funvill/tokyo-metro-pcb/input/reference/Tokyo_subway_map_(metro).png

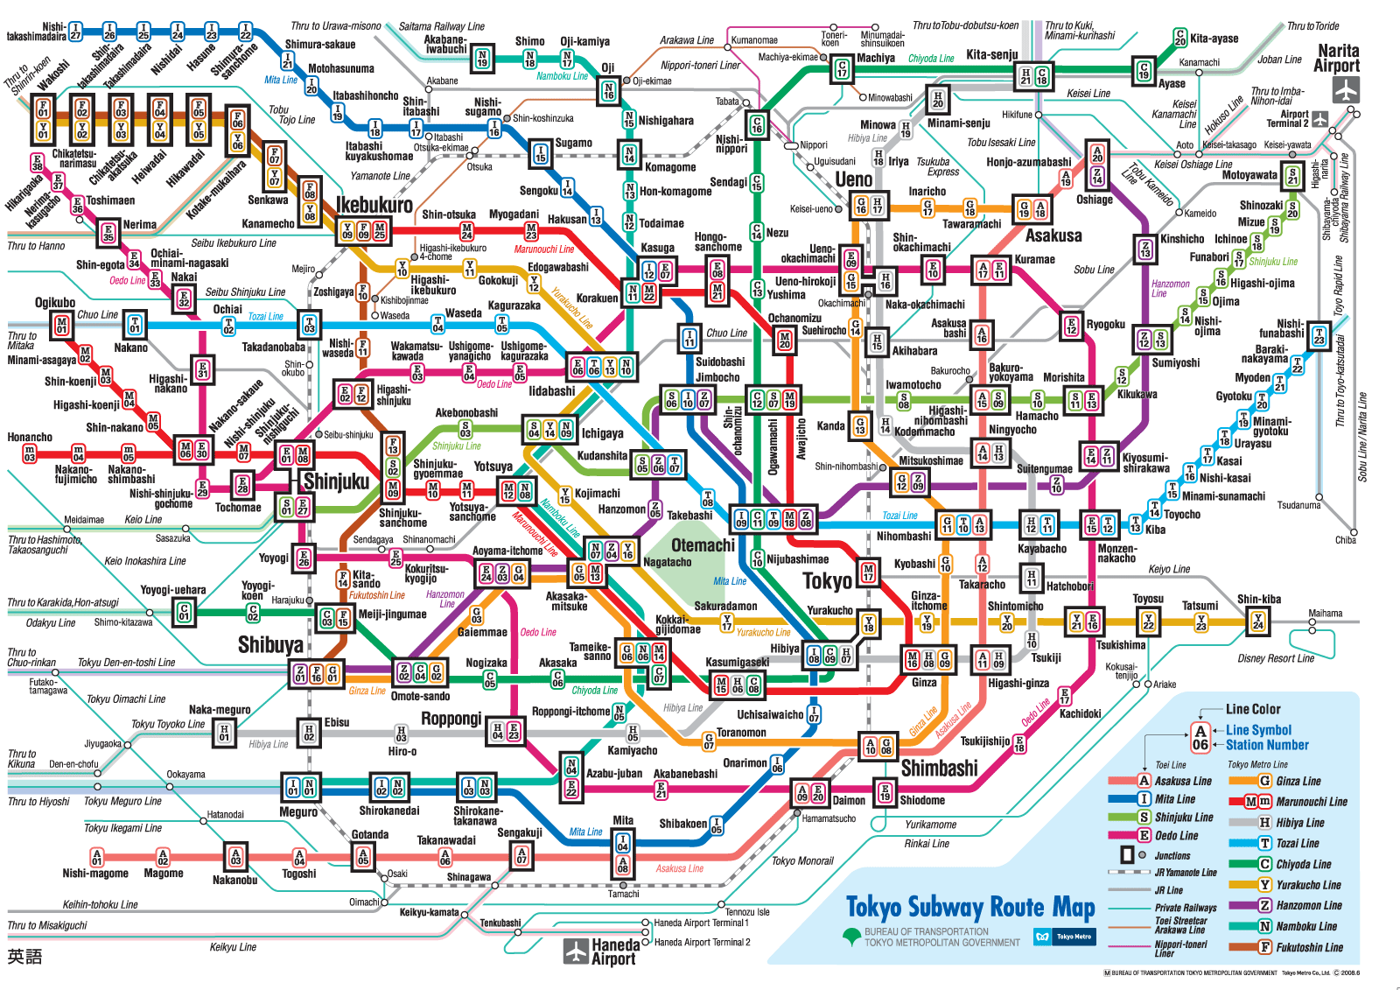
input/reference/Tokyo_subway_map_(metro).png
