funvill/tokyo-metro-pcb/hardware/leds.csv

index | ref | station | name | x_mm | y_mm | rotation
0 | LED1 | shin-kiba | Shin-kiba | 250.084 | 201.26 | 180
1 | LED2 | tatsumi | Tatsumi | 229.098 | 201.948 | 225
2 | LED3 | shinonome | Shinonome | 219.714 | 209.59 | 225
3 | LED4 | ariake | Ariake | 206.75 | 219.444 | 225
4 | LED5 | tokyo-big-sight | Tokyo Big Sight | 203.17 | 225.84 | 90
5 | LED6 | kokusai-tenjijo | Kokusai-tenjijo | 203.428 | 219.794 | 90
6 | LED7 | ariake-tennis-no-mori | Ariake-Tennis-no-mori | 200.162 | 210.596 | 135
7 | LED8 | shijo-mae | Shijo-mae | 196.196 | 201.488 | 45
8 | LED9 | shin-toyosu | Shin-Toyosu | 202.01 | 196.676 | 45
9 | LED10 | toyosu | Toyosu | 209.9 | 186.718 | 45
10 | LED11 | edagawa | Edagawa | 224.042 | 180.784 | 90
11 | LED12 | kiba | Kiba | 223.524 | 161.378 | 0
12 | LED13 | toyocho | Toyocho | 237.978 | 163.088 | 90
13 | LED14 | sengoku-koto | Sengoku | 236.004 | 147.798 | 90
14 | LED15 | sumiyoshi | Sumiyoshi | 235.618 | 131.83 | 90
15 | LED16 | kinshicho | Kinshicho | 234.772 | 120.044 | 225
16 | LED17 | kikukawa | Kikukawa | 223.014 | 132.766 | 225
17 | LED18 | kiyosumi-shirakawa | Kiyosumi-shirakawa | 213.274 | 142.624 | 270
18 | LED19 | monzen-nakacho | Monzen-nakacho | 208.708 | 157.748 | 225
19 | LED20 | tsukishima | Tsukishima | 194.542 | 171.448 | 225
20 | LED21 | kachidoki | Kachidoki | 184.856 | 180.222 | 90
21 | LED22 | tsukiji | Tsukiji | 178.816 | 165.522 | 90
22 | LED23 | shintomicho | Shintomicho | 179.908 | 161.416 | 90
23 | LED24 | takaracho | Takaracho | 177.95 | 153.736 | 135
24 | LED25 | kyobashi | Kyobashi | 175.388 | 151.594 | 225
25 | LED26 | ginza-itchome | Ginza-itchome | 171.488 | 155.434 | 225
26 | LED27 | ginza | Ginza | 167.62 | 159.014 | 135
27 | LED28 | hibiya | Hibiya | 163.31 | 155.658 | 45
28 | LED29 | yurakucho | Yurakucho | 165.034 | 152.82 | 90
29 | LED30 | nijubashimae | Nijubashimae | 166.276 | 146.342 | 45
30 | LED31 | tokyo | Tokyo | 168.754 | 143.076 | 90
31 | LED32 | otemachi | Otemachi | 168.546 | 137.026 | 135
32 | LED33 | takebashi | Takebashi | 160.568 | 130.054 | 90
33 | LED34 | jimbocho | Jimbocho | 159.524 | 121.132 | 180
34 | LED35 | kudanshita | Kudanshita | 149.988 | 121.348 | 135
35 | LED36 | iidabashi | Iidabashi | 144.538 | 112.686 | 0
36 | LED37 | suidobashi | Suidobashi | 155.906 | 108.046 | 135
37 | LED38 | korakuen | Korakuen | 150.894 | 101.682 | 45
38 | LED39 | kasuga | Kasuga | 153.072 | 99.152 | 0
39 | LED40 | hongo-sanchome | Hongo-sanchome | 162.556 | 102.698 | 315
40 | LED41 | ochanomizu | Ochanomizu | 168.212 | 111.272 | 270
41 | LED42 | shin-ochanomizu | Shin-ochanomizu | 169.634 | 118.584 | 270
42 | LED43 | ogawamachi | Ogawamachi | 169.636 | 122.348 | 0
43 | LED44 | awajicho | Awajicho | 172.952 | 121.954 | 315
44 | LED45 | kanda | Kanda | 176.572 | 124.228 | 0
45 | LED46 | iwamotocho | Iwamotocho | 182.372 | 121.966 | 90
46 | LED47 | akihabara | Akihabara | 182.672 | 116.18 | 135
47 | LED48 | suehirocho | Suehirocho | 177.612 | 109.37 | 45
48 | LED49 | okachimachi | Okachimachi | 181.344 | 103.256 | 180
49 | LED50 | ueno-hirokoji | Ueno-hirokoji | 178.18 | 102.184 | 180
50 | LED51 | yushima | Yushima | 174.872 | 102.302 | 45
51 | LED52 | ueno-okachimachi | Ueno-okachimachi | 180.598 | 99.872 | 315
52 | LED53 | naka-okachimachi | Naka-okachimachi | 184.58 | 103.942 | 315
53 | LED54 | asakusabashi | Asakusabashi | 196.898 | 118.304 | 45
54 | LED55 | kuramae | Kuramae | 203.97 | 107.068 | 0
55 | LED56 | honjo-azumabashi | Honjo-azumabashi | 220.676 | 100.308 | 0
56 | LED57 | oshiage | Oshiage | 232.148 | 97.55 | 180
57 | LED58 | asakusa | Asakusa | 210.312 | 97.39 | 180
58 | LED59 | tawaramachi | Tawaramachi | 202.756 | 98.254 | 180
59 | LED60 | shin-okachimachi | Shin-okachimachi | 191.01 | 102.726 | 90
60 | LED61 | inaricho | Inaricho | 192.12 | 95.754 | 180
61 | LED62 | ueno | Ueno | 184.444 | 95.146 | 180
62 | LED63 | todaimae | Todaimae | 159.814 | 86.168 | 45
63 | LED64 | sendagi | Sendagi | 166.496 | 72.906 | 90
64 | LED65 | tabata | Tabata | 164.464 | 53.89 | 315
65 | LED66 | nishi-nippori | Nishi-nippori | 171.73 | 61.602 | 0
66 | LED67 | arakawa-kuyakushomae | Arakawa-kuyakushomae | 197.07 | 57.802 | 315
67 | LED68 | arakawa-itchumae | Arakawa-itchumae | 200.352 | 59.778 | 315
68 | LED69 | minowabashi | Minowabashi | 203.874 | 62.32 | 0
69 | LED70 | minami-senju | Minami-senju | 213.364 | 61.972 | 225
70 | LED71 | minowa | Minowa | 203.476 | 66.49 | 225
71 | LED72 | iriya | Iriya | 194.62 | 80.734 | 180
72 | LED73 | uguisudani | Uguisudani | 185.832 | 79.134 | 135
73 | LED74 | nippori | Nippori | 176.346 | 68.532 | 270
74 | LED75 | nezu | Nezu | 169.754 | 86.08 | 180
75 | LED76 | hakusan | Hakusan | 151.88 | 79.452 | 90
76 | LED77 | hon-komagome | Hon-komagome | 153.914 | 74.202 | 180
77 | LED78 | sengoku | Sengoku | 142.44 | 69.452 | 90
78 | LED79 | komagome | Komagome | 144.766 | 56.118 | 180
79 | LED80 | sugamo | Sugamo | 133.508 | 59.664 | 135
80 | LED81 | shin-koshinzuka | Shin-koshinzuka | 123.504 | 47.194 | 270
81 | LED82 | koshinzuka | Koshinzuka | 122.298 | 50.31 | 45
82 | LED83 | nishigahara | Nishigahara | 138.718 | 39.904 | 45
83 | LED84 | kajiwara | Kajiwara | 146.158 | 31.8 | 0
84 | LED85 | arakawa-shakomae | Arakawa-shakomae | 152.592 | 32.104 | 0
85 | LED86 | arakawa-yuenchimae | Arakawa-yuenchimae | 159.424 | 32.44 | 0
86 | LED87 | odai | Odai | 164.876 | 32.702 | 315
87 | LED88 | machiya | Machiya | 187.996 | 46.736 | 45
88 | LED89 | machiya-ekimae | Machiya-ekimae | 190.55 | 44.584 | 315
89 | LED90 | arakawa-nanachome | Arakawa-nanachome | 194.016 | 46.424 | 45
90 | LED91 | ayase | Ayase | 247.722 | 14.0 | 225
91 | LED92 | kita-senju | Kita-Senju | 221.478 | 34.212 | 225
92 | LED93 | arakawa-nichome | Arakawa-nichome | 194.728 | 51.746 | 135
93 | LED94 | machiya-nichome | Machiya-nichome | 184.35 | 43.568 | 135
94 | LED95 | higashi-ogu-sanchome | Higashi-ogu-sanchome | 180.762 | 40.68 | 135
95 | LED96 | kumanomae | Kumanomae | 175.098 | 35.512 | 180
96 | LED97 | miyanomae | Miyanomae | 169.158 | 33.472 | 180
97 | LED98 | oji-ekimae | Oji-ekimae | 135.318 | 26.22 | 180
98 | LED99 | oji | Oji | 132.01 | 26.68 | 315
99 | LED100 | sakaecho | Sakaecho | 138.898 | 32.072 | 180
100 | LED101 | asukayama | Asukayama | 132.436 | 33.248 | 225
101 | LED102 | takinogawa-itchome | Takinogawa-itchome | 129.786 | 37.892 | 225
102 | LED103 | nishigahara-yonchome | Nishigahara-yonchome | 126.552 | 42.276 | 180
103 | LED104 | nishi-sugamo | Nishi-sugamo | 120.956 | 43.926 | 135
104 | LED105 | shin-itabashi | Shin-itabashi | 109.364 | 35.478 | 135
105 | LED106 | itabashihoncho | Itabashihoncho | 90.412 | 15.124 | 270
106 | LED107 | itabashi-kuyakushomae | Itabashi-kuyakushomae | 96.364 | 31.368 | 180
107 | LED108 | kotake-mukaihara | Kotake-mukaihara | 56.144 | 44.218 | 135
108 | LED109 | hikawadai | Hikawadai | 37.06 | 32.292 | 135
109 | LED110 | heiwadai | Heiwadai | 22.676 | 21.152 | 270
110 | LED111 | toshimaen | Toshimaen | 16.008 | 46.154 | 315
111 | LED112 | nerima | Nerima | 23.144 | 53.932 | 0
112 | LED113 | shin-egota | Shin-egota | 44.136 | 61.572 | 315
113 | LED114 | ochiai-minami-nagasaki | Ochiai-minami-nagasaki | 61.484 | 76.68 | 90
114 | LED115 | senkawa | Senkawa | 69.112 | 52.354 | 315
115 | LED116 | kanamecho | Kanamecho | 81.394 | 60.542 | 0
116 | LED117 | ikebukuro | Ikebukuro | 96.362 | 65.22 | 270
117 | LED118 | mejiro | Mejiro | 91.65 | 79.956 | 270
118 | LED119 | takadanobaba | Takadanobaba | 89.458 | 93.288 | 180
119 | LED120 | nakai | Nakai | 65.364 | 93.02 | 270
120 | LED121 | ochiai | Ochiai | 64.562 | 96.92 | 0
121 | LED122 | nishi-waseda | Nishi-waseda | 95.046 | 101.316 | 225
122 | LED123 | shin-okubo | Shin-Okubo | 83.448 | 112.006 | 315
123 | LED124 | higashi-shinjuku | Higashi-shinjuku | 93.174 | 116.654 | 315
124 | LED125 | yotsuya-sanchome | Yotsuya-sanchome | 110.25 | 133.454 | 45
125 | LED126 | akebonobashi | Akebonobashi | 113.266 | 126.322 | 90
126 | LED127 | ushigome-yanagicho | Ushigome-yanagicho | 116.84 | 114.978 | 180
127 | LED128 | wakamatsu-kawada | Wakamatsu-kawada | 107.394 | 115.254 | 90
128 | LED129 | waseda | Waseda | 111.062 | 104.752 | 135
129 | LED130 | omokagebashi | Omokagebashi | 100.468 | 95.032 | 90
130 | LED131 | gakushuinshita | Gakushuinshita | 99.718 | 87.372 | 90
131 | LED132 | zoshigaya | Zoshigaya | 101.174 | 80.734 | 315
132 | LED133 | kishibojimmae | Kishibojimmae | 104.14 | 82.274 | 90
133 | LED134 | toden-zoshigaya | Toden-zoshigaya | 106.678 | 75.3 | 90
134 | LED135 | higashi-ikebukuro | Higashi-ikebukuro | 107.772 | 72.156 | 315
135 | LED136 | higashi-ikebukuro-yonchome | Higashi-ikebukuro-yonchome | 110.648 | 73.906 | 45
136 | LED137 | mukohara | Mukohara | 116.22 | 67.3 | 45
137 | LED138 | otsuka | Otsuka | 119.736 | 62.562 | 90
138 | LED139 | sugamoshinden | Sugamoshinden | 119.68 | 56.844 | 315
139 | LED140 | otsuka-ekimae | Otsuka-ekimae | 122.78 | 63.936 | 270
140 | LED141 | shin-otsuka | Shin-otsuka | 122.572 | 72.56 | 270
141 | LED142 | gokokuji | Gokokuji | 119.33 | 83.36 | 0
142 | LED143 | myogadani | Myogadani | 131.822 | 86.404 | 270
143 | LED144 | edogawabashi | Edogawabashi | 126.388 | 100.958 | 270
144 | LED145 | kagurazaka | Kagurazaka | 128.124 | 107.768 | 315
145 | LED146 | ushigome-kagurazaka | Ushigome-kagurazaka | 130.516 | 112.628 | 270
146 | LED147 | ichigaya | Ichigaya | 133.11 | 127.982 | 225
147 | LED148 | yotsuya | Yotsuya | 122.296 | 137.794 | 180
148 | LED149 | kokuritsu-kyogijo | Kokuritsu-kyogijo | 101.51 | 146.164 | 90
149 | LED150 | shinjuku-gyoemmae | Shinjuku-gyoemmae | 97.286 | 132.512 | 135
150 | LED151 | shinjuku-sanchome | Shinjuku-sanchome | 89.78 | 128.85 | 180
151 | LED152 | shinjuku | Shinjuku | 82.626 | 130.646 | 90
152 | LED153 | shinjuku-nishiguchi | Shinjuku-nishiguchi | 82.044 | 125.158 | 180
153 | LED154 | nishi-shinjuku | Nishi-shinjuku | 73.596 | 123.072 | 270
154 | LED155 | tochomae | Tochomae | 73.658 | 129.236 | 180
155 | LED156 | nishi-shinjuku-gochome | Nishi-shinjuku-gochome | 62.722 | 130.4 | 180
156 | LED157 | nakano-shimbashi | Nakano-shimbashi | 49.65 | 128.658 | 180
157 | LED158 | nakano-fujimicho | Nakano-fujimicho | 41.124 | 131.218 | 90
158 | LED159 | shin-nakano | Shin-nakano | 41.796 | 118.194 | 0
159 | LED160 | nakano-sakaue | Nakano-sakaue | 59.844 | 118.61 | 90
160 | LED161 | higashi-nakano | Higashi-nakano | 61.028 | 102.262 | 180
161 | LED162 | nakano | Nakano | 37.702 | 104.71 | 225
162 | LED163 | higashi-koenji | Higashi-koenji | 27.978 | 117.368 | 180
163 | LED164 | shin-koenji | Shin-koenji | 15.494 | 117.526 | 315
164 | LED165 | honancho | Honancho | 27.358 | 140.684 | 315
165 | LED166 | yoyogi-uehara | Yoyogi-Uehara | 56.488 | 164.036 | 0
166 | LED167 | yoyogi-koen | Yoyogi-koen | 70.074 | 163.97 | 315
167 | LED168 | shibuya | Shibuya | 86.128 | 179.836 | 45
168 | LED169 | omote-sando | Omote-sando | 99.664 | 170.234 | 135
169 | LED170 | meiji-jingumae | Meiji-jingumae | 89.524 | 164.538 | 135
170 | LED171 | harajuku | Harajuku | 86.32 | 162.082 | 90
171 | LED172 | yoyogi | Yoyogi | 85.234 | 140.574 | 315
172 | LED173 | kita-sando | Kita-sando | 90.266 | 148.746 | 315
173 | LED174 | gaiemmae | Gaiemmae | 106.7 | 161.688 | 315
174 | LED175 | nogizaka | Nogizaka | 117.882 | 167.81 | 315
175 | LED176 | roppongi | Roppongi | 124.848 | 173.384 | 0
176 | LED177 | roppongi-itchome | Roppongi-itchome | 134.338 | 170.536 | 0
177 | LED178 | kamiyacho | Kamiyacho | 142.508 | 173.774 | 225
178 | LED179 | azabu-juban | Azabu-juban | 130.508 | 184.504 | 0
179 | LED180 | akabanebashi | Akabanebashi | 141.506 | 184.172 | 0
180 | LED181 | shibakoen | Shibakoen | 148.534 | 186.69 | 45
181 | LED182 | daimon | Daimon | 155.676 | 183.648 | 135
182 | LED183 | onarimon | Onarimon | 150.828 | 177.258 | 135
183 | LED184 | toranomon-hills | Toranomon Hills | 146.09 | 166.516 | 45
184 | LED185 | toranomon | Toranomon | 149.11 | 162.136 | 45
185 | LED186 | kasumigaseki | Kasumigaseki | 151.408 | 156.76 | 90
186 | LED187 | sakuradamon | Sakuradamon | 151.686 | 152.428 | 180
187 | LED188 | kokkai-gijidomae | Kokkai-gijidomae | 141.774 | 155.8 | 90
188 | LED189 | hanzomon | Hanzomon | 137.942 | 137.914 | 180
189 | LED190 | kojimachi | Kojimachi | 132.758 | 139.842 | 270
190 | LED191 | nagatacho | Nagatacho | 135.718 | 149.032 | 225
191 | LED192 | akasaka-mitsuke | Akasaka-mitsuke | 132.592 | 152.252 | 270
192 | LED193 | akasaka | Akasaka | 131.094 | 158.854 | 0
193 | LED194 | tameike-sanno | Tameike-sanno | 138.086 | 158.792 | 180
194 | LED195 | aoyama-itchome | Aoyama-itchome | 114.79 | 157.958 | 270
195 | LED196 | hiro-o | Hiro-o | 112.396 | 191.338 | 225
196 | LED197 | ebisu | Ebisu | 94.526 | 199.536 | 180
197 | LED198 | naka-meguro | Naka-meguro | 80.73 | 204.94 | 315
198 | LED199 | meguro | Meguro | 103.92 | 222.844 | 45
199 | LED200 | shirokanedai | Shirokanedai | 118.146 | 213.83 | 315
200 | LED201 | takanawadai | Takanawadai | 123.236 | 224.09 | 270
201 | LED202 | osaki | Osaki | 120.702 | 243.966 | 135
202 | LED203 | gotanda | Gotanda | 115.046 | 231.576 | 225
203 | LED204 | togoshi | Togoshi | 104.7 | 251.856 | 270
204 | LED205 | nakanobu | Nakanobu | 101.126 | 266.756 | 0
205 | LED206 | oimachi | Oimachi | 128.796 | 264.072 | 0
206 | LED207 | shinagawa-seaside | Shinagawa Seaside | 147.664 | 259.466 | 45
207 | LED208 | tokyo-international-cruise-terminal | Tokyo International Cruise Terminal | 179.458 | 240.738 | 315
208 | LED209 | telecom-center | Telecom Center | 187.846 | 246.918 | 90
209 | LED210 | aomi | Aomi | 189.678 | 234.796 | 135
210 | LED211 | tokyo-teleport | Tokyo Teleport | 186.054 | 231.572 | 90
211 | LED212 | odaiba-kaihinkoen | Odaiba-kaihinkoen | 187.004 | 227.036 | 225
212 | LED213 | daiba | Daiba | 177.254 | 233.516 | 180
213 | LED214 | tennozu-isle | Tennozu Isle | 149.466 | 239.874 | 135
214 | LED215 | shinagawa | Shinagawa | 134.758 | 229.03 | 90
215 | LED216 | takanawa-gateway | Takanawa Gateway | 136.736 | 218.188 | 90
216 | LED217 | sengakuji | Sengakuji | 135.86 | 212.914 | 135
217 | LED218 | shirokane-takanawa | Shirokane-takanawa | 128.158 | 206.036 | 0
218 | LED219 | tamachi | Tamachi | 145.972 | 201.576 | 90
219 | LED220 | mita | Mita | 146.94 | 198.38 | 315
220 | LED221 | shibaura-futo | Shibaura-futo | 159.28 | 207.992 | 90
221 | LED222 | hinode | Hinode | 160.628 | 195.93 | 45
222 | LED223 | takeshiba | Takeshiba | 164.744 | 188.238 | 180
223 | LED224 | hamamatsucho | Hamamatsucho | 158.336 | 186.424 | 90
224 | LED225 | shiodome | Shiodome | 162.576 | 173.332 | 90
225 | LED226 | shimbashi | Shimbashi | 161.064 | 168.406 | 135
226 | LED227 | uchisaiwaicho | Uchisaiwaicho | 156.128 | 163.314 | 315
227 | LED228 | tsukijishijo | Tsukijishijo | 171.292 | 170.688 | 90
228 | LED229 | higashi-ginza | Higashi-Ginza | 171.58 | 162.838 | 45
229 | LED230 | hatchobori | Hatchobori | 184.722 | 154.382 | 45
230 | LED231 | kayabacho | Kayabacho | 188.028 | 146.74 | 135
231 | LED232 | nihombashi | Nihombashi | 181.418 | 143.036 | 90
232 | LED233 | mitsukoshimae | Mitsukoshimae | 179.816 | 136.654 | 0
233 | LED234 | suitengumae | Suitengumae | 196.014 | 142.258 | 135
234 | LED235 | ningyocho | Ningyocho | 191.614 | 136.284 | 135
235 | LED236 | kodemmacho | Kodemmacho | 186.542 | 129.0 | 0
236 | LED237 | bakuroyokoyama | Bakuroyokoyama | 191.972 | 126.794 | 0
237 | LED238 | higashi-nihombashi | Higashi-nihombashi | 195.312 | 126.79 | 315
238 | LED239 | hamacho | Hamacho | 199.312 | 132.672 | 0
239 | LED240 | morishita | Morishita | 211.046 | 133.438 | 90
240 | LED241 | ryogoku | Ryogoku | 211.552 | 119.17 | 0
241 | LED242 | nishi-ojima | Nishi-ojima | 250.052 | 131.224 | 0
242 | LED243 | ojima | Ojima | 261.178 | 130.586 | 0
243 | LED244 | higashi-ojima | Higashi-ojima | 275.114 | 129.72 | 315
244 | LED245 | funabori | Funabori | 299.696 | 140.152 | 270
245 | LED246 | kasai | Kasai | 310.76 | 172.704 | 180
246 | LED247 | nishi-kasai | Nishi-kasai | 293.13 | 171.17 | 180
247 | LED248 | minami-sunamachi | Minami-sunamachi | 256.944 | 165.104 | 180
