funvill/tokyo-metro-pcb/hardware/tokyo-metro-pcb.kicad_pcb

## KiCad design hardware/tokyo-metro-pcb.kicad_pcb (2026-10-22)

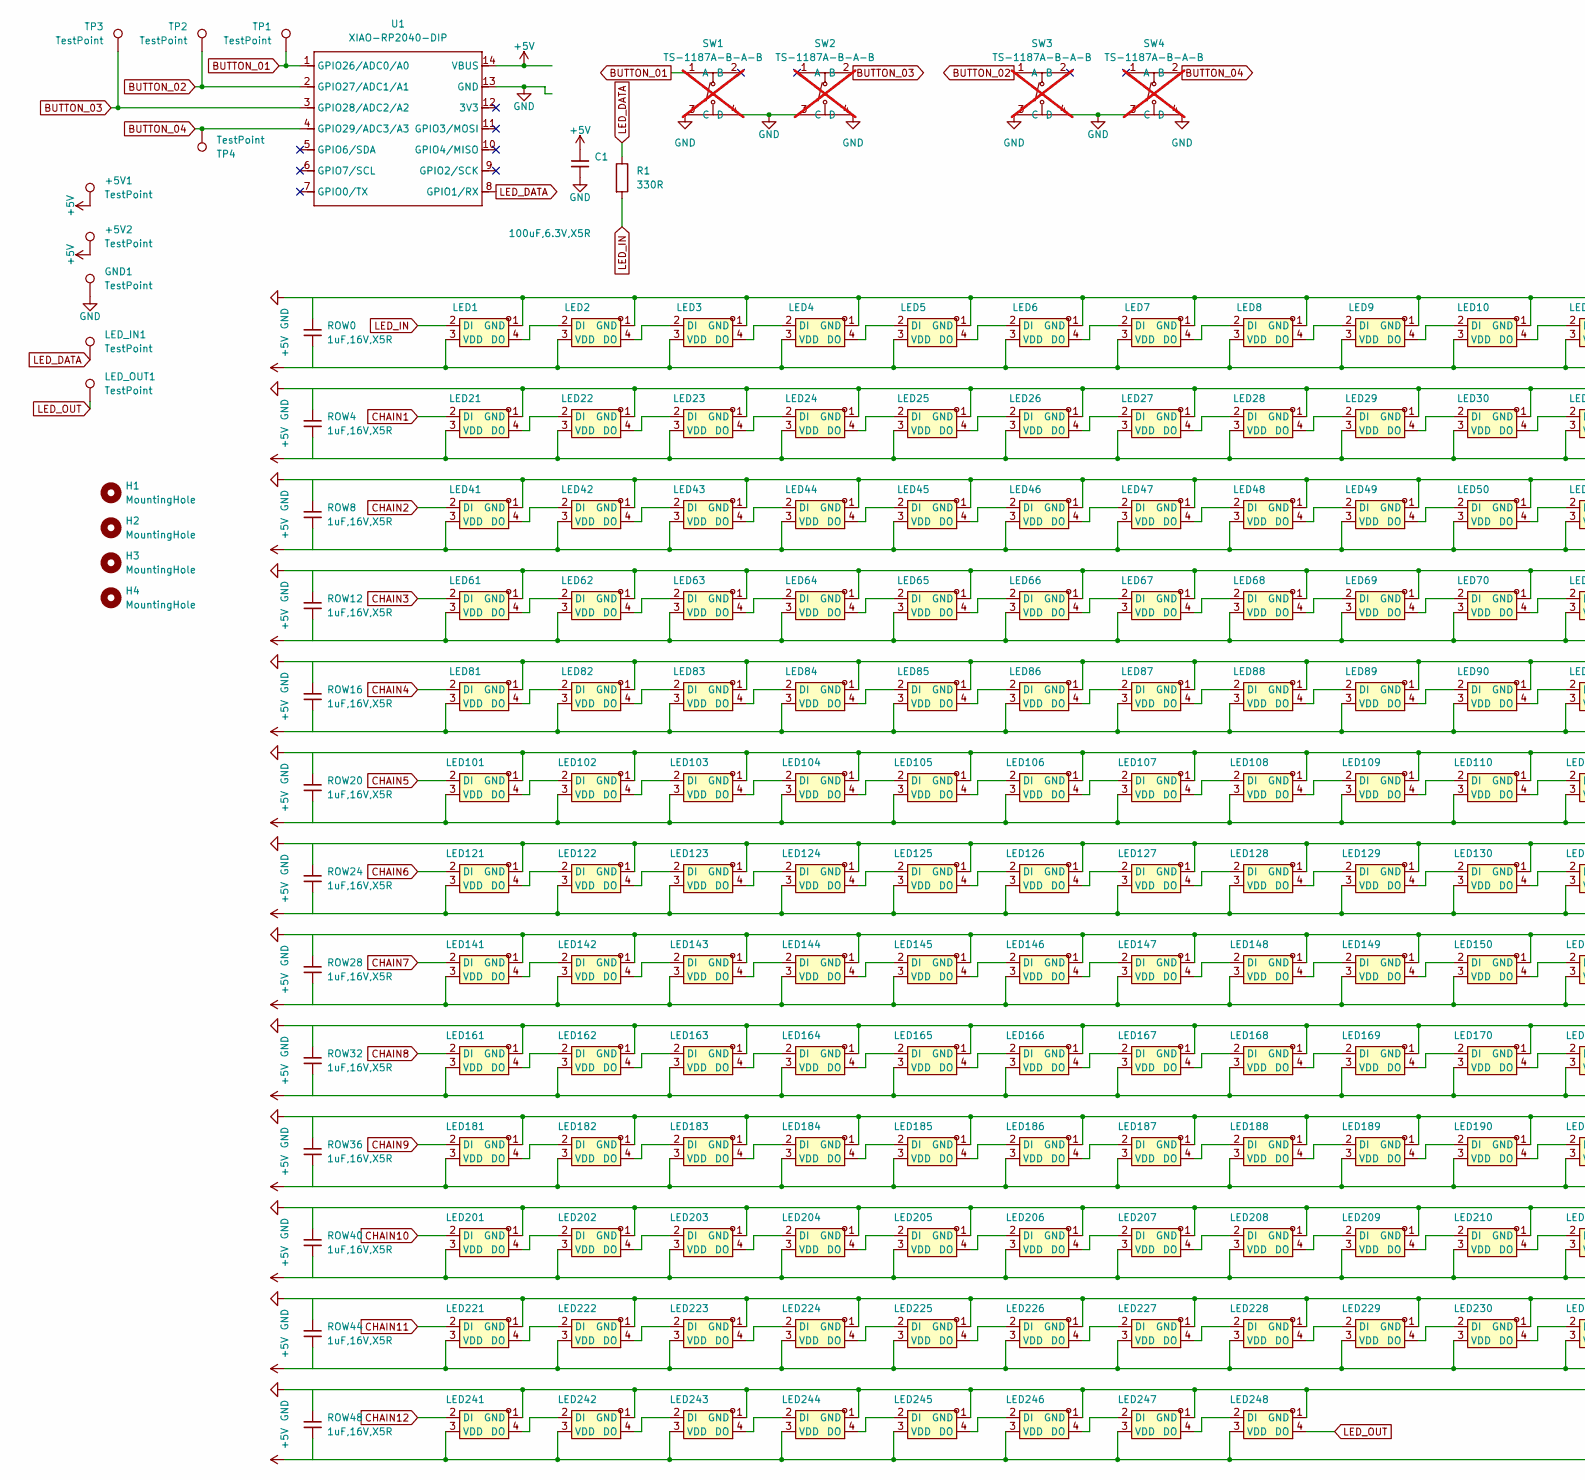
[picture p3: schematic tokyo-metro-pcb.kicad_sch, part in row 1, column 1]

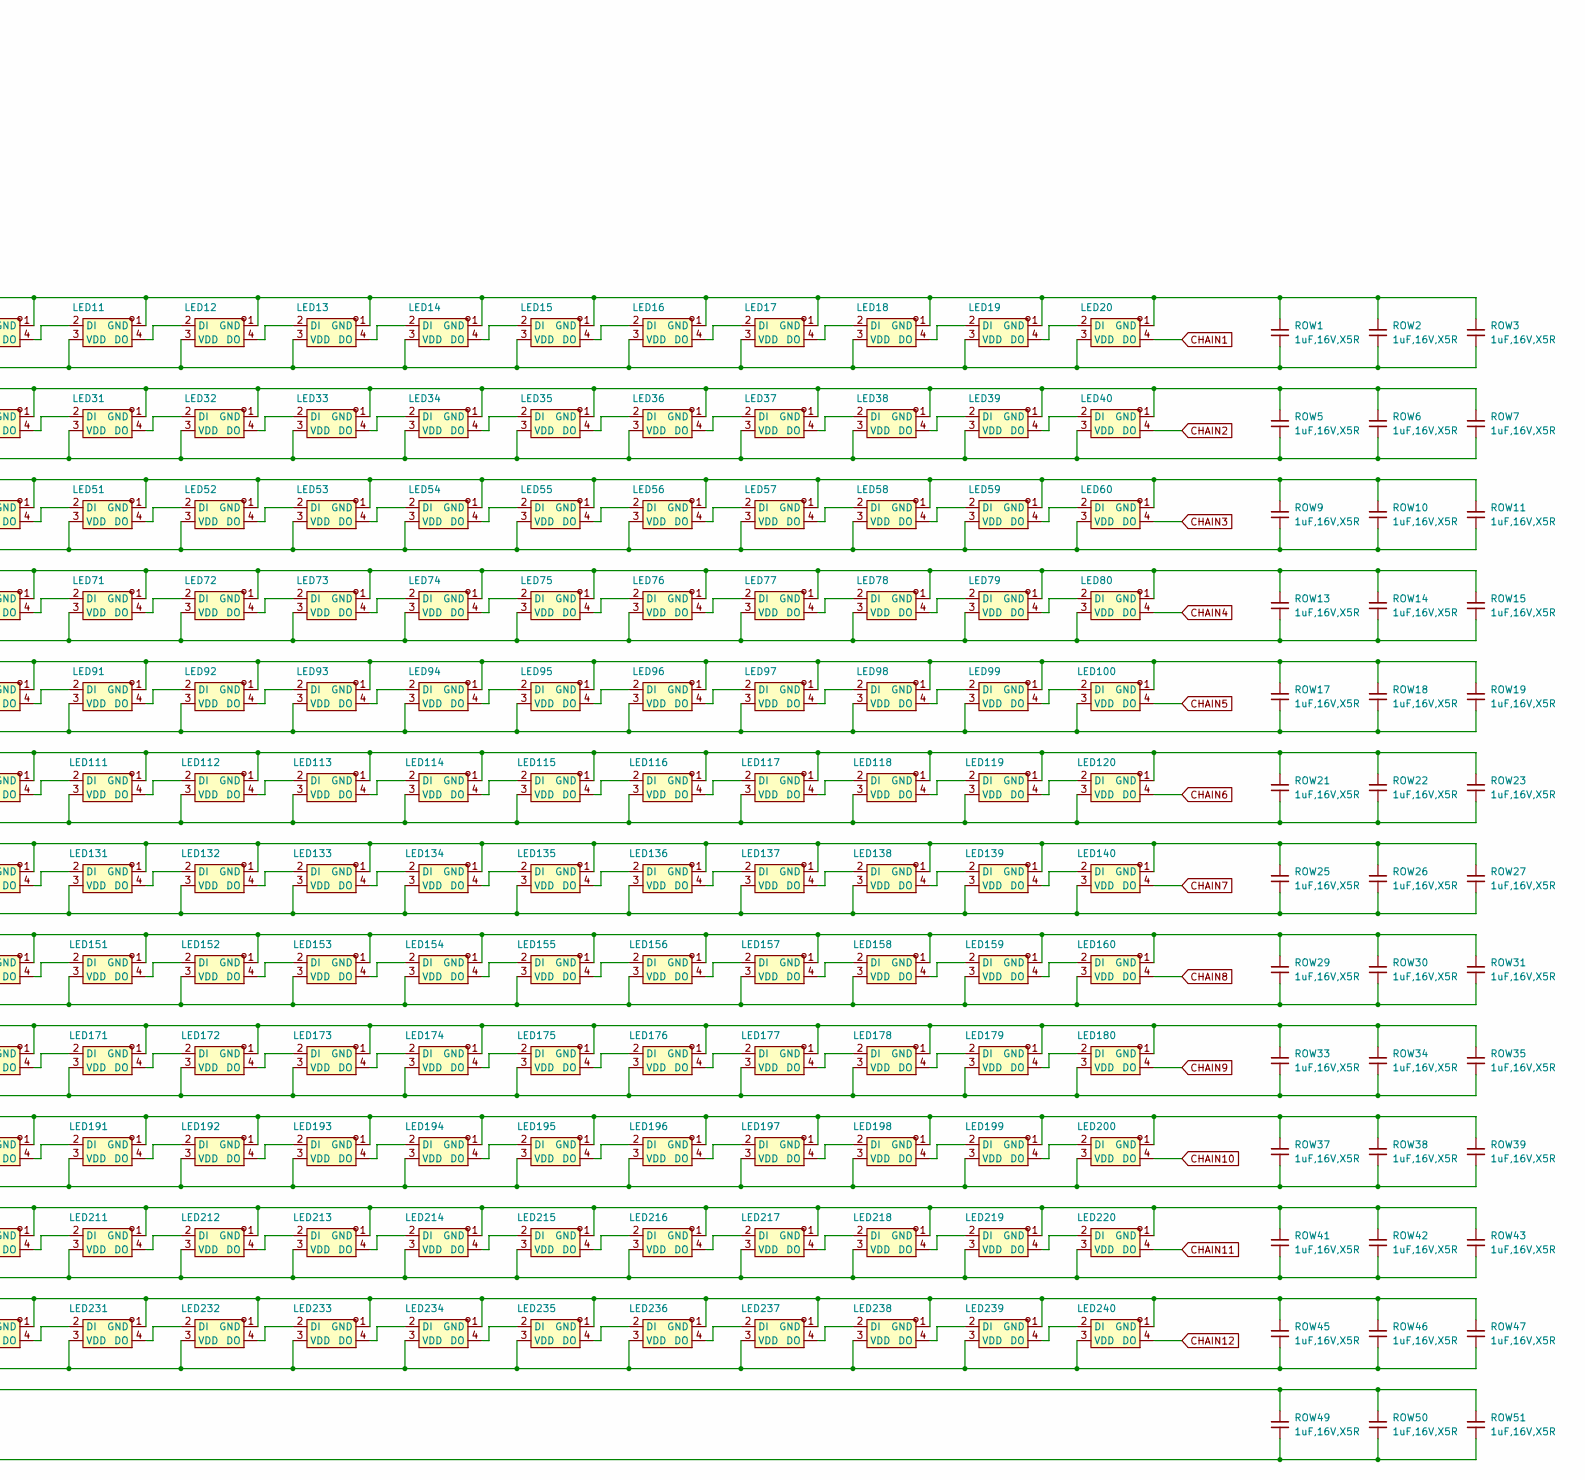
[picture p4: schematic tokyo-metro-pcb.kicad_sch, part in row 1, column 2]

Parts:
+5V1, +5V2: TestPoint; TestPoint_Pad_3.0x3.0mm
C1: 100uF,6.3V,X5R; C_1206_3216Metric; MFGPN CL31A107MQHNNNE; LCSC C15008
GND1: TestPoint; TestPoint_Pad_3.0x3.0mm
H1, H2, H3, H4: MountingHole; MountingHole_3.2mm_M3_DIN965_Pad_TopBottom
LED1, LED2, LED3, LED4, LED5, LED6, LED7, LED8, LED9, LED10, LED11, LED12, LED13, LED14, LED15, LED16, LED17, LED18, LED19, LED20, LED21, LED22, LED23, LED24, LED25, LED26, LED27, LED28, LED29, LED30, LED31, LED32, LED33, LED34, LED35, LED36, LED37, LED38, LED39, LED40, LED41, LED42, LED43, LED44, LED45, LED46, LED47, LED48, LED49, LED50, LED51, LED52, LED53, LED54, LED55, LED56, LED57, LED58, LED59, LED60, LED61, LED62, LED63, LED64, LED65, LED66, LED67, LED68, LED69, LED70, LED71, LED72, LED73, LED74, LED75, LED76, LED77, LED78, LED79, LED80, LED81, LED82, LED83, LED84, LED85, LED86, LED87, LED88, LED89, LED90, LED91, LED92, LED93, LED94, LED95, LED96, LED97, LED98, LED99, LED100, LED101, LED102, LED103, LED104, LED105, LED106, LED107, LED108, LED109, LED110, LED111, LED112, LED113, LED114, LED115, LED116, LED117, LED118, LED119, LED120, LED121, LED122, LED123, LED124, LED125, LED126, LED127, LED128, LED129, LED130, LED131, LED132, LED133, LED134, LED135, LED136, LED137, LED138, LED139, LED140, LED141, LED142, LED143, LED144, LED145, LED146, LED147, LED148, LED149, LED150, LED151, LED152, LED153, LED154, LED155, LED156, LED157, LED158, LED159, LED160, LED161, LED162, LED163, LED164, LED165, LED166, LED167, LED168, LED169, LED170, LED171, LED172, LED173, LED174, LED175, LED176, LED177, LED178, LED179, LED180, LED181, LED182, LED183, LED184, LED185, LED186, LED187, LED188, LED189, LED190, LED191, LED192, LED193, LED194, LED195, LED196, LED197, LED198, LED199, LED200, LED201, LED202, LED203, LED204, LED205, LED206, LED207, LED208, LED209, LED210, LED211, LED212, LED213, LED214, LED215, LED216, LED217, LED218, LED219, LED220, LED221, LED222, LED223, LED224, LED225, LED226, LED227, LED228, LED229, LED230, LED231, LED232, LED233, LED234, LED235, LED236, LED237, LED238, LED239, LED240, LED241, LED242, LED243, LED244, LED245, LED246, LED247, LED248: XL-1615RGBC-WS2812B; LED-SMD_4P-L1.6-W1.5_XL-1615RGBC-WS2812B-1; LCSC Part C5349954
LED_IN1: TestPoint; TestPoint_Pad_3.0x3.0mm
LED_OUT1: TestPoint; TestPoint_Pad_3.0x3.0mm
R1: 330R; R_0402_1005Metric; MFGPN 0402WGF3300TCE; LCSC C25104
ROW0, ROW1, ROW2, ROW3, ROW4, ROW5, ROW6, ROW7, ROW8, ROW9, ROW10, ROW11, ROW12, ROW13, ROW14, ROW15, ROW16, ROW17, ROW18, ROW19, ROW20, ROW21, ROW22, ROW23, ROW24, ROW25, ROW26, ROW27, ROW28, ROW29, ROW30, ROW31, ROW32, ROW33, ROW34, ROW35, ROW36, ROW37, ROW38, ROW39, ROW40, ROW41, ROW42, ROW43, ROW44, ROW45, ROW46, ROW47, ROW48, ROW49, ROW50, ROW51: 1uF,16V,X5R; C_0402_1005Metric; MFGPN CL05A105KA5NQNC; LCSC C52923
SW1, SW2, SW3, SW4: TS-1187A-B-A-B; SW-SMD_4P-L5.1-W5.1-P3.70-LS6.5-TL_H1.5; LCSC Part C318884; not fitted
TP1, TP2, TP3, TP4: TestPoint; TestPoint_Pad_3.0x3.0mm
U1: XIAO-RP2040-DIP; XIAO-RP2040-SMD

Connections:
+5V: +5V1.1 (1_1), +5V2.1 (1_1), C1.1, LED1.3 (VDD), LED2.3 (VDD), LED3.3 (VDD), LED4.3 (VDD), LED5.3 (VDD), LED6.3 (VDD), LED7.3 (VDD), LED8.3 (VDD), LED9.3 (VDD), LED10.3 (VDD), LED11.3 (VDD), LED12.3 (VDD), LED13.3 (VDD), LED14.3 (VDD), LED15.3 (VDD), LED16.3 (VDD), LED17.3 (VDD), LED18.3 (VDD), LED19.3 (VDD), LED20.3 (VDD), LED21.3 (VDD), LED22.3 (VDD), LED23.3 (VDD), LED24.3 (VDD), LED25.3 (VDD), LED26.3 (VDD), LED27.3 (VDD), LED28.3 (VDD), LED29.3 (VDD), LED30.3 (VDD), LED31.3 (VDD), LED32.3 (VDD), LED33.3 (VDD), LED34.3 (VDD), LED35.3 (VDD), LED36.3 (VDD), LED37.3 (VDD), LED38.3 (VDD), LED39.3 (VDD), LED40.3 (VDD), LED41.3 (VDD), LED42.3 (VDD), LED43.3 (VDD), LED44.3 (VDD), LED45.3 (VDD), LED46.3 (VDD), LED47.3 (VDD), LED48.3 (VDD), LED49.3 (VDD), LED50.3 (VDD), LED51.3 (VDD), LED52.3 (VDD), LED53.3 (VDD), LED54.3 (VDD), LED55.3 (VDD), LED56.3 (VDD), LED57.3 (VDD), LED58.3 (VDD), LED59.3 (VDD), LED60.3 (VDD), LED61.3 (VDD), LED62.3 (VDD), LED63.3 (VDD), LED64.3 (VDD), LED65.3 (VDD), LED66.3 (VDD), LED67.3 (VDD), LED68.3 (VDD), LED69.3 (VDD), LED70.3 (VDD), LED71.3 (VDD), LED72.3 (VDD), LED73.3 (VDD), LED74.3 (VDD), LED75.3 (VDD), LED76.3 (VDD), LED77.3 (VDD), LED78.3 (VDD), LED79.3 (VDD), LED80.3 (VDD), LED81.3 (VDD), LED82.3 (VDD), LED83.3 (VDD), LED84.3 (VDD), LED85.3 (VDD), LED86.3 (VDD), LED87.3 (VDD), LED88.3 (VDD), LED89.3 (VDD), LED90.3 (VDD), LED91.3 (VDD), LED92.3 (VDD), LED93.3 (VDD), LED94.3 (VDD), LED95.3 (VDD), LED96.3 (VDD), LED97.3 (VDD), LED98.3 (VDD), LED99.3 (VDD), LED100.3 (VDD), LED101.3 (VDD), LED102.3 (VDD), LED103.3 (VDD), LED104.3 (VDD), LED105.3 (VDD), LED106.3 (VDD), LED107.3 (VDD), LED108.3 (VDD), LED109.3 (VDD), LED110.3 (VDD), LED111.3 (VDD), LED112.3 (VDD), LED113.3 (VDD), LED114.3 (VDD), LED115.3 (VDD), LED116.3 (VDD), LED117.3 (VDD), LED118.3 (VDD), LED119.3 (VDD), LED120.3 (VDD), LED121.3 (VDD), LED122.3 (VDD), LED123.3 (VDD), LED124.3 (VDD), LED125.3 (VDD), LED126.3 (VDD), LED127.3 (VDD), LED128.3 (VDD), LED129.3 (VDD), LED130.3 (VDD), LED131.3 (VDD), LED132.3 (VDD), LED133.3 (VDD), LED134.3 (VDD), LED135.3 (VDD), LED136.3 (VDD), LED137.3 (VDD), LED138.3 (VDD), LED139.3 (VDD), LED140.3 (VDD), LED141.3 (VDD), LED142.3 (VDD), LED143.3 (VDD), LED144.3 (VDD), LED145.3 (VDD), LED146.3 (VDD), LED147.3 (VDD), LED148.3 (VDD), LED149.3 (VDD), LED150.3 (VDD), LED151.3 (VDD), LED152.3 (VDD), LED153.3 (VDD), LED154.3 (VDD), LED155.3 (VDD), LED156.3 (VDD), LED157.3 (VDD), LED158.3 (VDD), LED159.3 (VDD), LED160.3 (VDD), LED161.3 (VDD), LED162.3 (VDD), LED163.3 (VDD), LED164.3 (VDD), LED165.3 (VDD), LED166.3 (VDD), LED167.3 (VDD), LED168.3 (VDD), LED169.3 (VDD), LED170.3 (VDD), LED171.3 (VDD), LED172.3 (VDD), LED173.3 (VDD), LED174.3 (VDD), LED175.3 (VDD), LED176.3 (VDD), LED177.3 (VDD), LED178.3 (VDD), LED179.3 (VDD), LED180.3 (VDD), LED181.3 (VDD), LED182.3 (VDD), LED183.3 (VDD), LED184.3 (VDD), LED185.3 (VDD), LED186.3 (VDD), LED187.3 (VDD), LED188.3 (VDD), LED189.3 (VDD), LED190.3 (VDD), LED191.3 (VDD), LED192.3 (VDD), LED193.3 (VDD), LED194.3 (VDD), LED195.3 (VDD), LED196.3 (VDD), LED197.3 (VDD), LED198.3 (VDD), LED199.3 (VDD), LED200.3 (VDD), LED201.3 (VDD), LED202.3 (VDD), LED203.3 (VDD), LED204.3 (VDD), LED205.3 (VDD), LED206.3 (VDD), LED207.3 (VDD), LED208.3 (VDD), LED209.3 (VDD), LED210.3 (VDD), LED211.3 (VDD), LED212.3 (VDD), LED213.3 (VDD), LED214.3 (VDD), LED215.3 (VDD), LED216.3 (VDD), LED217.3 (VDD), LED218.3 (VDD), LED219.3 (VDD), LED220.3 (VDD), LED221.3 (VDD), LED222.3 (VDD), LED223.3 (VDD), LED224.3 (VDD), LED225.3 (VDD), LED226.3 (VDD), LED227.3 (VDD), LED228.3 (VDD), LED229.3 (VDD), LED230.3 (VDD), LED231.3 (VDD), LED232.3 (VDD), LED233.3 (VDD), LED234.3 (VDD), LED235.3 (VDD), LED236.3 (VDD), LED237.3 (VDD), LED238.3 (VDD), LED239.3 (VDD), LED240.3 (VDD), LED241.3 (VDD), LED242.3 (VDD), LED243.3 (VDD), LED244.3 (VDD), LED245.3 (VDD), LED246.3 (VDD), LED247.3 (VDD), LED248.3 (VDD), ROW0.2, ROW1.2, ROW2.2, ROW3.2, ROW4.2, ROW5.2, ROW6.2, ROW7.2, ROW8.2, ROW9.2, ROW10.2, ROW11.2, ROW12.2, ROW13.2, ROW14.2, ROW15.2, ROW16.2, ROW17.2, ROW18.2, ROW19.2, ROW20.2, ROW21.2, ROW22.2, ROW23.2, ROW24.2, ROW25.2, ROW26.2, ROW27.2, ROW28.2, ROW29.2, ROW30.2, ROW31.2, ROW32.2, ROW33.2, ROW34.2, ROW35.2, ROW36.2, ROW37.2, ROW38.2, ROW39.2, ROW40.2, ROW41.2, ROW42.2, ROW43.2, ROW44.2, ROW45.2, ROW46.2, ROW47.2, ROW48.2, ROW49.2, ROW50.2, ROW51.2, U1.14 (VBUS)
BUTTON_01: SW1.1 (A), TP1.1 (1_1), U1.1 (GPIO26/ADC0/A0)
BUTTON_02: SW3.1 (A), TP2.1 (1_1), U1.2 (GPIO27/ADC1/A1)
BUTTON_03: SW2.2 (B), TP3.1 (1_1), U1.3 (GPIO28/ADC2/A2)
BUTTON_04: SW4.2 (B), TP4.1 (1_1), U1.4 (GPIO29/ADC3/A3)
CHAIN1: LED20.4 (DO), LED21.2 (DI)
CHAIN2: LED40.4 (DO), LED41.2 (DI)
CHAIN3: LED60.4 (DO), LED61.2 (DI)
CHAIN4: LED80.4 (DO), LED81.2 (DI)
CHAIN5: LED100.4 (DO), LED101.2 (DI)
CHAIN6: LED120.4 (DO), LED121.2 (DI)
CHAIN7: LED140.4 (DO), LED141.2 (DI)
CHAIN8: LED160.4 (DO), LED161.2 (DI)
CHAIN9: LED180.4 (DO), LED181.2 (DI)
CHAIN10: LED200.4 (DO), LED201.2 (DI)
CHAIN11: LED220.4 (DO), LED221.2 (DI)
CHAIN12: LED240.4 (DO), LED241.2 (DI)
GND: C1.2, GND1.1 (1_1), LED1.1 (GND), LED2.1 (GND), LED3.1 (GND), LED4.1 (GND), LED5.1 (GND), LED6.1 (GND), LED7.1 (GND), LED8.1 (GND), LED9.1 (GND), LED10.1 (GND), LED11.1 (GND), LED12.1 (GND), LED13.1 (GND), LED14.1 (GND), LED15.1 (GND), LED16.1 (GND), LED17.1 (GND), LED18.1 (GND), LED19.1 (GND), LED20.1 (GND), LED21.1 (GND), LED22.1 (GND), LED23.1 (GND), LED24.1 (GND), LED25.1 (GND), LED26.1 (GND), LED27.1 (GND), LED28.1 (GND), LED29.1 (GND), LED30.1 (GND), LED31.1 (GND), LED32.1 (GND), LED33.1 (GND), LED34.1 (GND), LED35.1 (GND), LED36.1 (GND), LED37.1 (GND), LED38.1 (GND), LED39.1 (GND), LED40.1 (GND), LED41.1 (GND), LED42.1 (GND), LED43.1 (GND), LED44.1 (GND), LED45.1 (GND), LED46.1 (GND), LED47.1 (GND), LED48.1 (GND), LED49.1 (GND), LED50.1 (GND), LED51.1 (GND), LED52.1 (GND), LED53.1 (GND), LED54.1 (GND), LED55.1 (GND), LED56.1 (GND), LED57.1 (GND), LED58.1 (GND), LED59.1 (GND), LED60.1 (GND), LED61.1 (GND), LED62.1 (GND), LED63.1 (GND), LED64.1 (GND), LED65.1 (GND), LED66.1 (GND), LED67.1 (GND), LED68.1 (GND), LED69.1 (GND), LED70.1 (GND), LED71.1 (GND), LED72.1 (GND), LED73.1 (GND), LED74.1 (GND), LED75.1 (GND), LED76.1 (GND), LED77.1 (GND), LED78.1 (GND), LED79.1 (GND), LED80.1 (GND), LED81.1 (GND), LED82.1 (GND), LED83.1 (GND), LED84.1 (GND), LED85.1 (GND), LED86.1 (GND), LED87.1 (GND), LED88.1 (GND), LED89.1 (GND), LED90.1 (GND), LED91.1 (GND), LED92.1 (GND), LED93.1 (GND), LED94.1 (GND), LED95.1 (GND), LED96.1 (GND), LED97.1 (GND), LED98.1 (GND), LED99.1 (GND), LED100.1 (GND), LED101.1 (GND), LED102.1 (GND), LED103.1 (GND), LED104.1 (GND), LED105.1 (GND), LED106.1 (GND), LED107.1 (GND), LED108.1 (GND), LED109.1 (GND), LED110.1 (GND), LED111.1 (GND), LED112.1 (GND), LED113.1 (GND), LED114.1 (GND), LED115.1 (GND), LED116.1 (GND), LED117.1 (GND), LED118.1 (GND), LED119.1 (GND), LED120.1 (GND), LED121.1 (GND), LED122.1 (GND), LED123.1 (GND), LED124.1 (GND), LED125.1 (GND), LED126.1 (GND), LED127.1 (GND), LED128.1 (GND), LED129.1 (GND), LED130.1 (GND), LED131.1 (GND), LED132.1 (GND), LED133.1 (GND), LED134.1 (GND), LED135.1 (GND), LED136.1 (GND), LED137.1 (GND), LED138.1 (GND), LED139.1 (GND), LED140.1 (GND), LED141.1 (GND), LED142.1 (GND), LED143.1 (GND), LED144.1 (GND), LED145.1 (GND), LED146.1 (GND), LED147.1 (GND), LED148.1 (GND), LED149.1 (GND), LED150.1 (GND), LED151.1 (GND), LED152.1 (GND), LED153.1 (GND), LED154.1 (GND), LED155.1 (GND), LED156.1 (GND), LED157.1 (GND), LED158.1 (GND), LED159.1 (GND), LED160.1 (GND), LED161.1 (GND), LED162.1 (GND), LED163.1 (GND), LED164.1 (GND), LED165.1 (GND), LED166.1 (GND), LED167.1 (GND), LED168.1 (GND), LED169.1 (GND), LED170.1 (GND), LED171.1 (GND), LED172.1 (GND), LED173.1 (GND), LED174.1 (GND), LED175.1 (GND), LED176.1 (GND), LED177.1 (GND), LED178.1 (GND), LED179.1 (GND), LED180.1 (GND), LED181.1 (GND), LED182.1 (GND), LED183.1 (GND), LED184.1 (GND), LED185.1 (GND), LED186.1 (GND), LED187.1 (GND), LED188.1 (GND), LED189.1 (GND), LED190.1 (GND), LED191.1 (GND), LED192.1 (GND), LED193.1 (GND), LED194.1 (GND), LED195.1 (GND), LED196.1 (GND), LED197.1 (GND), LED198.1 (GND), LED199.1 (GND), LED200.1 (GND), LED201.1 (GND), LED202.1 (GND), LED203.1 (GND), LED204.1 (GND), LED205.1 (GND), LED206.1 (GND), LED207.1 (GND), LED208.1 (GND), LED209.1 (GND), LED210.1 (GND), LED211.1 (GND), LED212.1 (GND), LED213.1 (GND), LED214.1 (GND), LED215.1 (GND), LED216.1 (GND), LED217.1 (GND), LED218.1 (GND), LED219.1 (GND), LED220.1 (GND), LED221.1 (GND), LED222.1 (GND), LED223.1 (GND), LED224.1 (GND), LED225.1 (GND), LED226.1 (GND), LED227.1 (GND), LED228.1 (GND), LED229.1 (GND), LED230.1 (GND), LED231.1 (GND), LED232.1 (GND), LED233.1 (GND), LED234.1 (GND), LED235.1 (GND), LED236.1 (GND), LED237.1 (GND), LED238.1 (GND), LED239.1 (GND), LED240.1 (GND), LED241.1 (GND), LED242.1 (GND), LED243.1 (GND), LED244.1 (GND), LED245.1 (GND), LED246.1 (GND), LED247.1 (GND), LED248.1 (GND), ROW0.1, ROW1.1, ROW2.1, ROW3.1, ROW4.1, ROW5.1, ROW6.1, ROW7.1, ROW8.1, ROW9.1, ROW10.1, ROW11.1, ROW12.1, ROW13.1, ROW14.1, ROW15.1, ROW16.1, ROW17.1, ROW18.1, ROW19.1, ROW20.1, ROW21.1, ROW22.1, ROW23.1, ROW24.1, ROW25.1, ROW26.1, ROW27.1, ROW28.1, ROW29.1, ROW30.1, ROW31.1, ROW32.1, ROW33.1, ROW34.1, ROW35.1, ROW36.1, ROW37.1, ROW38.1, ROW39.1, ROW40.1, ROW41.1, ROW42.1, ROW43.1, ROW44.1, ROW45.1, ROW46.1, ROW47.1, ROW48.1, ROW49.1, ROW50.1, ROW51.1, SW1.3 (C), SW1.4 (D), SW2.3 (C), SW2.4 (D), SW3.3 (C), SW3.4 (D), SW4.3 (C), SW4.4 (D), U1.13 (GND)
LED_DATA: LED_IN1.1 (1_1), R1.1, U1.8 (GPIO1/RX)
LED_IN: LED1.2 (DI), R1.2
LED_OUT: LED248.4 (DO), LED_OUT1.1 (1_1)
unnamed: LED1.4 (DO), LED2.2 (DI)
unnamed: LED2.4 (DO), LED3.2 (DI)
unnamed: LED3.4 (DO), LED4.2 (DI)
unnamed: LED4.4 (DO), LED5.2 (DI)
unnamed: LED5.4 (DO), LED6.2 (DI)
unnamed: LED6.4 (DO), LED7.2 (DI)
unnamed: LED7.4 (DO), LED8.2 (DI)
unnamed: LED8.4 (DO), LED9.2 (DI)
unnamed: LED9.4 (DO), LED10.2 (DI)
unnamed: LED10.4 (DO), LED11.2 (DI)
unnamed: LED11.4 (DO), LED12.2 (DI)
unnamed: LED12.4 (DO), LED13.2 (DI)
unnamed: LED13.4 (DO), LED14.2 (DI)
unnamed: LED14.4 (DO), LED15.2 (DI)
unnamed: LED15.4 (DO), LED16.2 (DI)
unnamed: LED16.4 (DO), LED17.2 (DI)
unnamed: LED17.4 (DO), LED18.2 (DI)
unnamed: LED18.4 (DO), LED19.2 (DI)
unnamed: LED19.4 (DO), LED20.2 (DI)
unnamed: LED21.4 (DO), LED22.2 (DI)
unnamed: LED22.4 (DO), LED23.2 (DI)
unnamed: LED23.4 (DO), LED24.2 (DI)
unnamed: LED24.4 (DO), LED25.2 (DI)
unnamed: LED25.4 (DO), LED26.2 (DI)
unnamed: LED26.4 (DO), LED27.2 (DI)
unnamed: LED27.4 (DO), LED28.2 (DI)
unnamed: LED28.4 (DO), LED29.2 (DI)
unnamed: LED29.4 (DO), LED30.2 (DI)
unnamed: LED30.4 (DO), LED31.2 (DI)
unnamed: LED31.4 (DO), LED32.2 (DI)
unnamed: LED32.4 (DO), LED33.2 (DI)
unnamed: LED33.4 (DO), LED34.2 (DI)
unnamed: LED34.4 (DO), LED35.2 (DI)
unnamed: LED35.4 (DO), LED36.2 (DI)
unnamed: LED36.4 (DO), LED37.2 (DI)
unnamed: LED37.4 (DO), LED38.2 (DI)
unnamed: LED38.4 (DO), LED39.2 (DI)
unnamed: LED39.4 (DO), LED40.2 (DI)
unnamed: LED41.4 (DO), LED42.2 (DI)
unnamed: LED42.4 (DO), LED43.2 (DI)
unnamed: LED43.4 (DO), LED44.2 (DI)
unnamed: LED44.4 (DO), LED45.2 (DI)
unnamed: LED45.4 (DO), LED46.2 (DI)
unnamed: LED46.4 (DO), LED47.2 (DI)
unnamed: LED47.4 (DO), LED48.2 (DI)
unnamed: LED48.4 (DO), LED49.2 (DI)
unnamed: LED49.4 (DO), LED50.2 (DI)
unnamed: LED50.4 (DO), LED51.2 (DI)
unnamed: LED51.4 (DO), LED52.2 (DI)
unnamed: LED52.4 (DO), LED53.2 (DI)
unnamed: LED53.4 (DO), LED54.2 (DI)
unnamed: LED54.4 (DO), LED55.2 (DI)
unnamed: LED55.4 (DO), LED56.2 (DI)
unnamed: LED56.4 (DO), LED57.2 (DI)
unnamed: LED57.4 (DO), LED58.2 (DI)
unnamed: LED58.4 (DO), LED59.2 (DI)
unnamed: LED59.4 (DO), LED60.2 (DI)
unnamed: LED61.4 (DO), LED62.2 (DI)
unnamed: LED62.4 (DO), LED63.2 (DI)
unnamed: LED63.4 (DO), LED64.2 (DI)
unnamed: LED64.4 (DO), LED65.2 (DI)
unnamed: LED65.4 (DO), LED66.2 (DI)
unnamed: LED66.4 (DO), LED67.2 (DI)
unnamed: LED67.4 (DO), LED68.2 (DI)
unnamed: LED68.4 (DO), LED69.2 (DI)
unnamed: LED69.4 (DO), LED70.2 (DI)
unnamed: LED70.4 (DO), LED71.2 (DI)
unnamed: LED71.4 (DO), LED72.2 (DI)
unnamed: LED72.4 (DO), LED73.2 (DI)
unnamed: LED73.4 (DO), LED74.2 (DI)
unnamed: LED74.4 (DO), LED75.2 (DI)
unnamed: LED75.4 (DO), LED76.2 (DI)
unnamed: LED76.4 (DO), LED77.2 (DI)
unnamed: LED77.4 (DO), LED78.2 (DI)
unnamed: LED78.4 (DO), LED79.2 (DI)
unnamed: LED79.4 (DO), LED80.2 (DI)
unnamed: LED81.4 (DO), LED82.2 (DI)
unnamed: LED82.4 (DO), LED83.2 (DI)
unnamed: LED83.4 (DO), LED84.2 (DI)
unnamed: LED84.4 (DO), LED85.2 (DI)
unnamed: LED85.4 (DO), LED86.2 (DI)
unnamed: LED86.4 (DO), LED87.2 (DI)
unnamed: LED87.4 (DO), LED88.2 (DI)
unnamed: LED88.4 (DO), LED89.2 (DI)
unnamed: LED89.4 (DO), LED90.2 (DI)
unnamed: LED90.4 (DO), LED91.2 (DI)
unnamed: LED91.4 (DO), LED92.2 (DI)
unnamed: LED92.4 (DO), LED93.2 (DI)
unnamed: LED93.4 (DO), LED94.2 (DI)
unnamed: LED94.4 (DO), LED95.2 (DI)
unnamed: LED95.4 (DO), LED96.2 (DI)
unnamed: LED96.4 (DO), LED97.2 (DI)
unnamed: LED97.4 (DO), LED98.2 (DI)
unnamed: LED98.4 (DO), LED99.2 (DI)
unnamed: LED99.4 (DO), LED100.2 (DI)
unnamed: LED101.4 (DO), LED102.2 (DI)
unnamed: LED102.4 (DO), LED103.2 (DI)
unnamed: LED103.4 (DO), LED104.2 (DI)
unnamed: LED104.4 (DO), LED105.2 (DI)
unnamed: LED105.4 (DO), LED106.2 (DI)
unnamed: LED106.4 (DO), LED107.2 (DI)
unnamed: LED107.4 (DO), LED108.2 (DI)
unnamed: LED108.4 (DO), LED109.2 (DI)
unnamed: LED109.4 (DO), LED110.2 (DI)
unnamed: LED110.4 (DO), LED111.2 (DI)
unnamed: LED111.4 (DO), LED112.2 (DI)
unnamed: LED112.4 (DO), LED113.2 (DI)
unnamed: LED113.4 (DO), LED114.2 (DI)
unnamed: LED114.4 (DO), LED115.2 (DI)
unnamed: LED115.4 (DO), LED116.2 (DI)
unnamed: LED116.4 (DO), LED117.2 (DI)
unnamed: LED117.4 (DO), LED118.2 (DI)
unnamed: LED118.4 (DO), LED119.2 (DI)
unnamed: LED119.4 (DO), LED120.2 (DI)
unnamed: LED121.4 (DO), LED122.2 (DI)
unnamed: LED122.4 (DO), LED123.2 (DI)
unnamed: LED123.4 (DO), LED124.2 (DI)
unnamed: LED124.4 (DO), LED125.2 (DI)
unnamed: LED125.4 (DO), LED126.2 (DI)
unnamed: LED126.4 (DO), LED127.2 (DI)
unnamed: LED127.4 (DO), LED128.2 (DI)
unnamed: LED128.4 (DO), LED129.2 (DI)
unnamed: LED129.4 (DO), LED130.2 (DI)
unnamed: LED130.4 (DO), LED131.2 (DI)
unnamed: LED131.4 (DO), LED132.2 (DI)
unnamed: LED132.4 (DO), LED133.2 (DI)
unnamed: LED133.4 (DO), LED134.2 (DI)
unnamed: LED134.4 (DO), LED135.2 (DI)
unnamed: LED135.4 (DO), LED136.2 (DI)
unnamed: LED136.4 (DO), LED137.2 (DI)
unnamed: LED137.4 (DO), LED138.2 (DI)
unnamed: LED138.4 (DO), LED139.2 (DI)
unnamed: LED139.4 (DO), LED140.2 (DI)
unnamed: LED141.4 (DO), LED142.2 (DI)
unnamed: LED142.4 (DO), LED143.2 (DI)
unnamed: LED143.4 (DO), LED144.2 (DI)
unnamed: LED144.4 (DO), LED145.2 (DI)
unnamed: LED145.4 (DO), LED146.2 (DI)
unnamed: LED146.4 (DO), LED147.2 (DI)
unnamed: LED147.4 (DO), LED148.2 (DI)
unnamed: LED148.4 (DO), LED149.2 (DI)
unnamed: LED149.4 (DO), LED150.2 (DI)
unnamed: LED150.4 (DO), LED151.2 (DI)
unnamed: LED151.4 (DO), LED152.2 (DI)
unnamed: LED152.4 (DO), LED153.2 (DI)
unnamed: LED153.4 (DO), LED154.2 (DI)
unnamed: LED154.4 (DO), LED155.2 (DI)
unnamed: LED155.4 (DO), LED156.2 (DI)
unnamed: LED156.4 (DO), LED157.2 (DI)
unnamed: LED157.4 (DO), LED158.2 (DI)
unnamed: LED158.4 (DO), LED159.2 (DI)
unnamed: LED159.4 (DO), LED160.2 (DI)
unnamed: LED161.4 (DO), LED162.2 (DI)
unnamed: LED162.4 (DO), LED163.2 (DI)
unnamed: LED163.4 (DO), LED164.2 (DI)
unnamed: LED164.4 (DO), LED165.2 (DI)
unnamed: LED165.4 (DO), LED166.2 (DI)
unnamed: LED166.4 (DO), LED167.2 (DI)
unnamed: LED167.4 (DO), LED168.2 (DI)
unnamed: LED168.4 (DO), LED169.2 (DI)
unnamed: LED169.4 (DO), LED170.2 (DI)
unnamed: LED170.4 (DO), LED171.2 (DI)
unnamed: LED171.4 (DO), LED172.2 (DI)
unnamed: LED172.4 (DO), LED173.2 (DI)
unnamed: LED173.4 (DO), LED174.2 (DI)
unnamed: LED174.4 (DO), LED175.2 (DI)
unnamed: LED175.4 (DO), LED176.2 (DI)
unnamed: LED176.4 (DO), LED177.2 (DI)
unnamed: LED177.4 (DO), LED178.2 (DI)
unnamed: LED178.4 (DO), LED179.2 (DI)
unnamed: LED179.4 (DO), LED180.2 (DI)
unnamed: LED181.4 (DO), LED182.2 (DI)
unnamed: LED182.4 (DO), LED183.2 (DI)
unnamed: LED183.4 (DO), LED184.2 (DI)
unnamed: LED184.4 (DO), LED185.2 (DI)
unnamed: LED185.4 (DO), LED186.2 (DI)
unnamed: LED186.4 (DO), LED187.2 (DI)
unnamed: LED187.4 (DO), LED188.2 (DI)
unnamed: LED188.4 (DO), LED189.2 (DI)
unnamed: LED189.4 (DO), LED190.2 (DI)
unnamed: LED190.4 (DO), LED191.2 (DI)
unnamed: LED191.4 (DO), LED192.2 (DI)
unnamed: LED192.4 (DO), LED193.2 (DI)
unnamed: LED193.4 (DO), LED194.2 (DI)
unnamed: LED194.4 (DO), LED195.2 (DI)
unnamed: LED195.4 (DO), LED196.2 (DI)
unnamed: LED196.4 (DO), LED197.2 (DI)
unnamed: LED197.4 (DO), LED198.2 (DI)
unnamed: LED198.4 (DO), LED199.2 (DI)
unnamed: LED199.4 (DO), LED200.2 (DI)
unnamed: LED201.4 (DO), LED202.2 (DI)
unnamed: LED202.4 (DO), LED203.2 (DI)
unnamed: LED203.4 (DO), LED204.2 (DI)
unnamed: LED204.4 (DO), LED205.2 (DI)
unnamed: LED205.4 (DO), LED206.2 (DI)
unnamed: LED206.4 (DO), LED207.2 (DI)
unnamed: LED207.4 (DO), LED208.2 (DI)
unnamed: LED208.4 (DO), LED209.2 (DI)
unnamed: LED209.4 (DO), LED210.2 (DI)
unnamed: LED210.4 (DO), LED211.2 (DI)
unnamed: LED211.4 (DO), LED212.2 (DI)
unnamed: LED212.4 (DO), LED213.2 (DI)
unnamed: LED213.4 (DO), LED214.2 (DI)
unnamed: LED214.4 (DO), LED215.2 (DI)
unnamed: LED215.4 (DO), LED216.2 (DI)
unnamed: LED216.4 (DO), LED217.2 (DI)
unnamed: LED217.4 (DO), LED218.2 (DI)
unnamed: LED218.4 (DO), LED219.2 (DI)
unnamed: LED219.4 (DO), LED220.2 (DI)
unnamed: LED221.4 (DO), LED222.2 (DI)
unnamed: LED222.4 (DO), LED223.2 (DI)
unnamed: LED223.4 (DO), LED224.2 (DI)
unnamed: LED224.4 (DO), LED225.2 (DI)
unnamed: LED225.4 (DO), LED226.2 (DI)
unnamed: LED226.4 (DO), LED227.2 (DI)
unnamed: LED227.4 (DO), LED228.2 (DI)
unnamed: LED228.4 (DO), LED229.2 (DI)
unnamed: LED229.4 (DO), LED230.2 (DI)
unnamed: LED230.4 (DO), LED231.2 (DI)
unnamed: LED231.4 (DO), LED232.2 (DI)
unnamed: LED232.4 (DO), LED233.2 (DI)
unnamed: LED233.4 (DO), LED234.2 (DI)
unnamed: LED234.4 (DO), LED235.2 (DI)
unnamed: LED235.4 (DO), LED236.2 (DI)
unnamed: LED236.4 (DO), LED237.2 (DI)
unnamed: LED237.4 (DO), LED238.2 (DI)
unnamed: LED238.4 (DO), LED239.2 (DI)
unnamed: LED239.4 (DO), LED240.2 (DI)
unnamed: LED241.4 (DO), LED242.2 (DI)
unnamed: LED242.4 (DO), LED243.2 (DI)
unnamed: LED243.4 (DO), LED244.2 (DI)
unnamed: LED244.4 (DO), LED245.2 (DI)
unnamed: LED245.4 (DO), LED246.2 (DI)
unnamed: LED246.4 (DO), LED247.2 (DI)
unnamed: LED247.4 (DO), LED248.2 (DI)

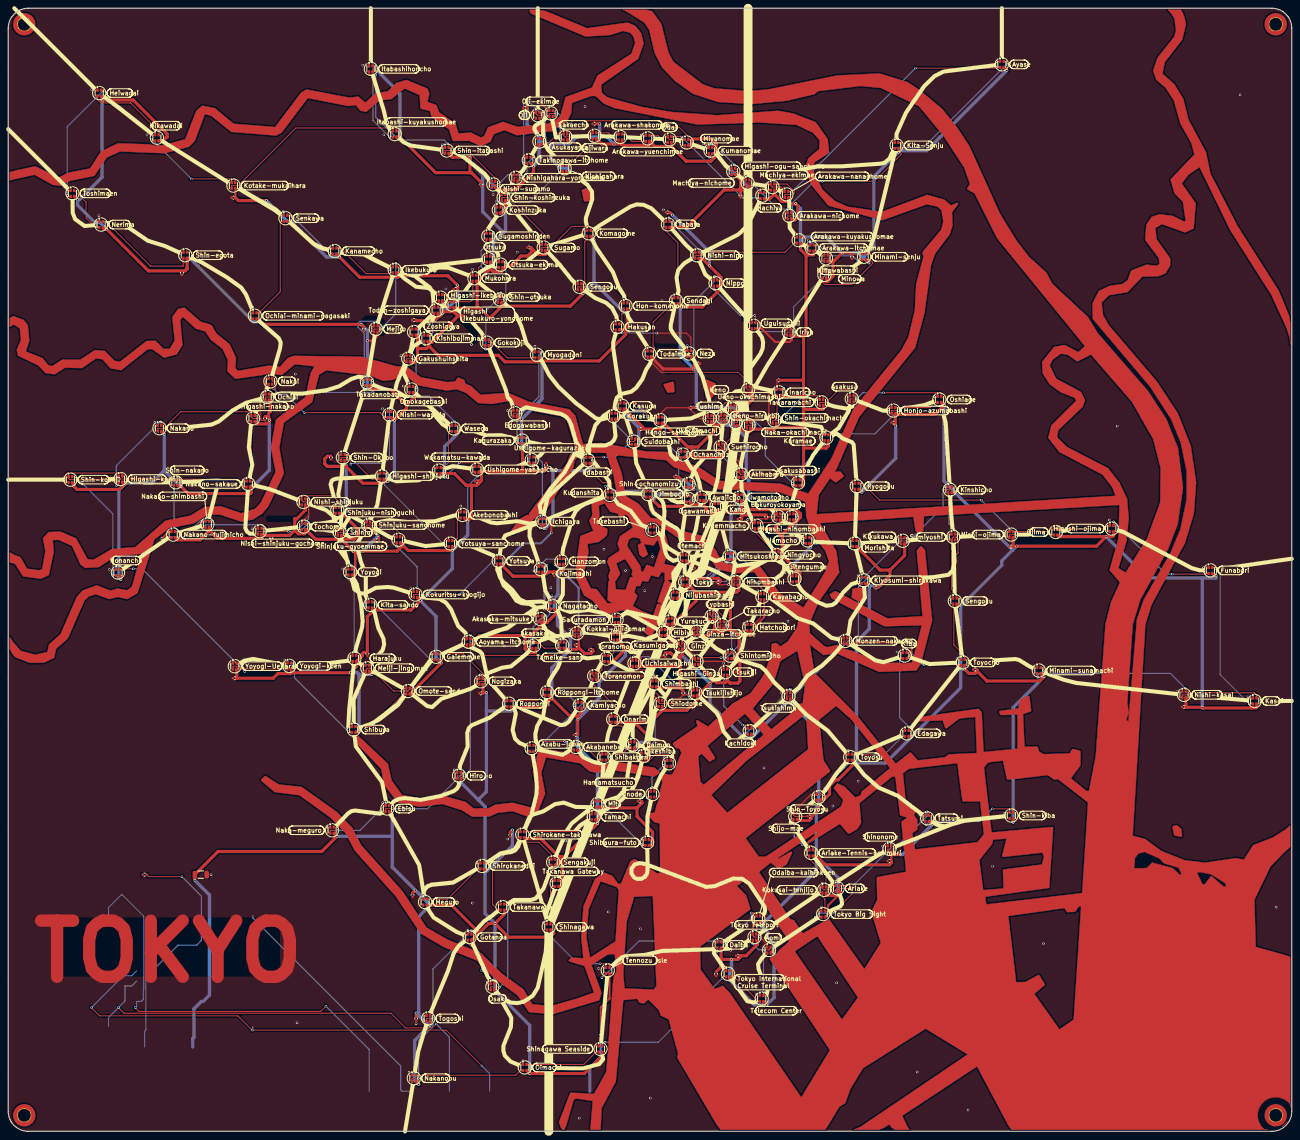
[picture p5: board tokyo-metro-pcb.kicad_pcb from above]

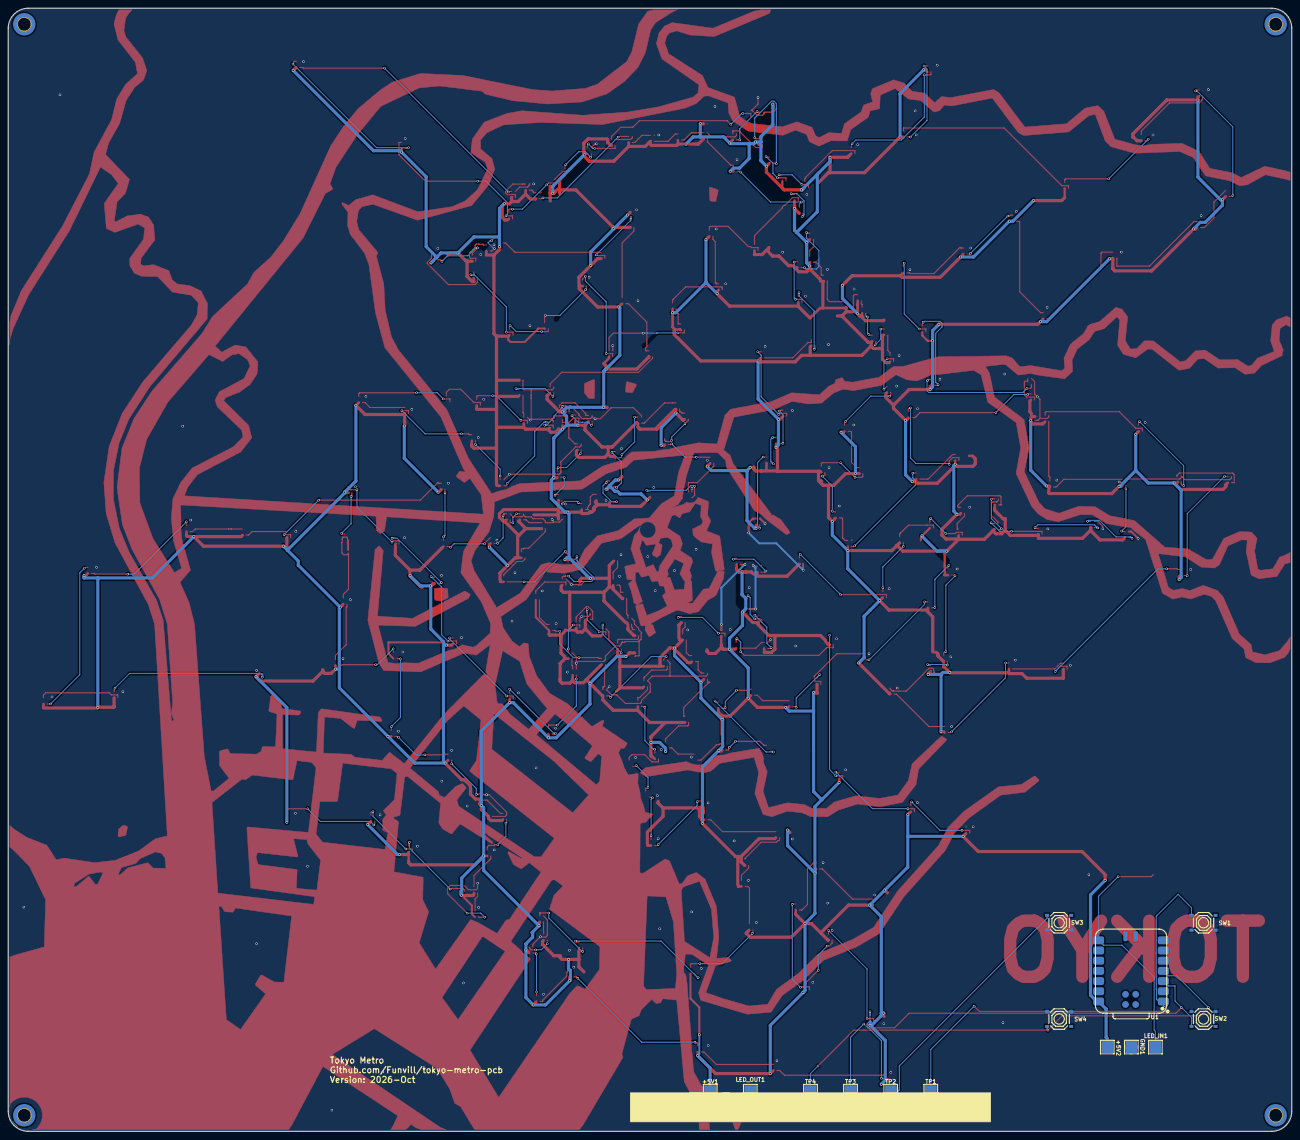
[picture p6: board tokyo-metro-pcb.kicad_pcb from below]

Board: 2 copper layers, 320.0 x 280.0 mm, 320 parts (14 on the bottom side), 256 nets.
