funvill/tokyo-metro-pcb/tools/citymap.py

"""City-agnostic transit-map model for LED PCB generation.

Loads a city JSON file (lines, stations, extras, geography) and provides
geometry helpers shared by the renderer, fit checker, and exporters.
All coordinates are millimeters on the board canvas, y-axis pointing down
(SVG convention).
"""
import json
import math
import os
from dataclasses import dataclass, field


DEFAULT_LABEL = {"angle": -45, "anchor": "start", "dx": 1.2, "dy": -1.2}

# Stroke-font metrics (KiCad-like): average advance per char and total box
# height (ascenders + descenders) as multiples of the nominal text height.
CHAR_W = 0.65  # Archivo Narrow SemiBold measures 0.709 mm per character at
               # a 1.1 mm cap height (0.645 x the height); rounded up for
               # margin. KiCad's own stroke font would be 0.85.
BOX_H = 1.25
LINE_PITCH = 1.6  # KiCad stroke-font interline pitch (multiple of size)

# Labels: the text block is vertically centred on its anchor point (KiCad's
# default vertical justification), horizontally anchored at its start or
# end. The anchor sits LABEL_STANDOFF mm from the LED centre along the
# label's own direction - clear of the 1.6 mm pad and the station ring.
LABEL_STANDOFF = 1.9
TEXT_H = 1.1   # station label height, mm - the one place it is set
KICAD_W_FUDGE = 1.03  # matplotlib outline metrics -> what KiCad actually draws
LABEL_HALO = 0.56  # clear border around a label, inside its capsule. Must
                   # exceed the font's descender depth (0.270 mm at this
                   # size) or a 'y' on the last line pokes through. Also
                   # the one place it is set: check_fit scores the capsule
                   # and preview_map draws it, and if those two disagree the
                   # optimiser is solving a board nobody is drawing.
WRAP_OVER = 22  # names longer than this are set on two lines. Raised from
                # 13: a hyphenated Japanese name is one word, and breaking
                # "Shinjuku-sanchome" across two lines reads as a mistake.
                # Wrapping was cheap when a wide label hit more routes; with
                # capsule knockouts a label may sit on a route, so the only
                # cost of a long pill is the space it takes. At 22 just two
                # names still wrap - the 26- and 35-character outliers - and
                # the widest single line is 15.7 mm, under 5% of the board.


@dataclass
class Station:
    id: str
    name: str
    x: float
    y: float
    short: str = ""
    future: bool = False
    interchange: bool = False
    label: dict = field(default_factory=lambda: dict(DEFAULT_LABEL))
    wrap: object = None  # None = auto, False = never, or explicit [lines]


@dataclass
class Line:
    id: str
    name: str
    color: str
    paths: list  # list of lists of station ids
    # optional drawn geometry: {"a|b": [[x, y], ...]} canvas points the route
    # passes through between adjacent stations a and b (rounded bends)
    shape: dict = field(default_factory=dict)
    # how heavy to draw this line relative to the others (the Shinkansen is
    # not a metro line), and the runs of track that leave the board edge
    weight: float = 1.0
    stubs: list = field(default_factory=list)


@dataclass
class City:
    name: str
    canvas_mm: float          # canvas width (board width = canvas_mm * scale)
    lines: list
    stations: dict  # id -> Station
    extras: list    # list of Station (SeaBus etc.)
    geo: list       # raw geo dicts
    annotations: list = field(default_factory=list)  # river/municipality labels
    canvas_h: float = None    # canvas height; None = square
    scale: float = 1.5        # board mm per canvas unit ("board_scale")

    @property
    def height(self):
        return self.canvas_h if self.canvas_h else self.canvas_mm


def load(path):
    with open(path, encoding="utf-8") as f:
        raw = json.load(f)
    stations = {}
    for sid, s in raw["stations"].items():
        label = dict(DEFAULT_LABEL)
        label.update(s.get("label", {}))
        stations[sid] = Station(
            id=sid, name=s["name"], x=s["x"], y=s["y"],
            short=s.get("short", s["name"]), future=s.get("future", False),
            interchange=s.get("interchange", False), label=label,
            wrap=s.get("wrap"))
    lines = [Line(l["id"], l["name"], l["color"], l["paths"], l.get("shape", {}),
                  l.get("weight", 1.0), l.get("stubs", []))
             for l in raw["lines"]]
    extras = []
    for e in raw.get("extras", []):
        label = dict(DEFAULT_LABEL)
        label.update(e.get("label", {}))
        extras.append(Station(id=e["id"], name=e["name"], x=e["x"], y=e["y"],
                              short=e.get("short", e["name"]), label=label))
    return City(raw["city"], raw["canvas_mm"], lines, stations, extras,
                raw.get("geo", []), raw.get("annotations", []),
                raw.get("canvas_h_mm"), raw.get("board_scale", 1.5))


def led_count(city):
    return len(city.stations) + len(city.extras)


def segments(city):
    """Yield (line_id, (x1,y1), (x2,y2), sid1, sid2) for every drawn segment."""
    for line in city.lines:
        for path in line.paths:
            for a, b in zip(path, path[1:]):
                sa, sb = city.stations[a], city.stations[b]
                via = line.shape.get(f"{a}|{b}")
                if via is None and f"{b}|{a}" in line.shape:
                    via = line.shape[f"{b}|{a}"][::-1]
                pts = [(sa.x, sa.y)] + [tuple(p) for p in via or []] + [(sb.x, sb.y)]
                for p1, p2 in zip(pts, pts[1:]):
                    yield line.id, p1, p2, a, b


def is_octilinear(p1, p2, tol=0.01):
    dx, dy = p2[0] - p1[0], p2[1] - p1[1]
    return (abs(dx) < tol or abs(dy) < tol or abs(abs(dx) - abs(dy)) < tol)


DASHES = "–—-"


def display_lines(st, use_short=False):
    """The label text as a list of lines. Long multi-part names are set on
    two lines (split at the en-dash the official names use, else at the
    space nearest the middle) - 'Joyce / Collingwood' reads at a glance
    where 'Joyce–Collingwood' as one 17 mm ribbon does not, and the short
    forms ('Bdwy', 'Bby') are no longer needed to make things fit."""
    if use_short:
        return [st.short]
    if isinstance(st.wrap, list):
        return list(st.wrap)
    name = st.name
    if st.label.get("short"):
        # optimiser fallback: the name's first part ("Great Northern
        # Way", "Sperling") where the full two-part name has no room.
        # An explicit short name wins: French names are hyphenated
        # throughout, and "Côte" is not a short form of "Côte-Vertu".
        if st.short != name:
            return [st.short]
        if "-" in name:
            return [name]
        for dash in DASHES:
            if dash in name:
                return [name.split(dash, 1)[0].strip()]
        return [st.short]
    if st.wrap is False or len(name) <= WRAP_OVER:
        return [name]
    for dash in DASHES:
        if dash in name:
            a, b = name.split(dash, 1)
            return [a.strip(), b.strip()]
    if " " in name:
        mid = len(name) / 2
        cut = min((i for i, ch in enumerate(name) if ch == " "),
                  key=lambda i: abs(i - mid))
        return [name[:cut], name[cut + 1:]]
    return [name]


def display_name(st, use_short=False):
    return "\n".join(display_lines(st, use_short))


def label_anchor(st, scale=1.0):
    """Board-mm position of the label's anchor point: LED centre plus the
    label's dx/dy. auto_label sets dx/dy from LABEL_STANDOFF along the
    text direction; a leader label just has a bigger dx/dy."""
    return st.x * scale + st.label["dx"], st.y * scale + st.label["dy"]


_TEXT_W_CACHE = {}
# The label face is loaded from the repo, not from the system: matplotlib
# does not know "Archivo Narrow" by name, and asking for it by family
# silently falls back to DejaVu - whose metrics are nothing like a
# condensed face, so every measured width would be wrong.
_FONT_TTF = os.path.join(os.path.dirname(os.path.abspath(__file__)),
                         "..", "fonts", "ArchivoNarrow-SemiBold.ttf")


def text_width(text, text_h):
    """Width of a line of label text, in mm - measured, not modelled.

    CHAR_W is one average advance for every glyph, and the real font does
    not work that way: across the 248 station names the advance ranges from
    0.49 to 0.72 of the text height, so a single constant is simultaneously
    too wide for most labels and too narrow for the widest. That mattered
    once the capsule was fitted to the drawn text: check_fit scored one
    shape while preview_map drew another.

    Measured once per distinct string and cached. Falls back to the CHAR_W
    model where matplotlib is not available, so build_tokyo and export_art
    keep working without it.
    """
    key = (text, round(text_h, 4))
    hit = _TEXT_W_CACHE.get(key)
    if hit is not None:
        return hit
    try:
        from matplotlib.textpath import TextPath
        from matplotlib.font_manager import FontProperties
        if not os.path.exists(_FONT_TTF):
            raise OSError(_FONT_TTF)
        size = text_h * (72.0 / 25.4) * 1.35      # as preview_map.font_pt
        ext = TextPath((0, 0), text, size=size,
                       prop=FontProperties(fname=_FONT_TTF)).get_extents()
        # x1, not width. KiCad puts the text ORIGIN at the anchor and the
        # ink starts a left side bearing further along (up to 0.095 mm
        # here), so a box the width of the ink alone is short by exactly
        # that much at the far end - which is where the overhang showed.
        # Measuring from the origin to the far edge of the ink covers both.
        w = ext.x1 / (72.0 / 25.4)
        # matplotlib's outline metrics run narrower than KiCad's renderer
        # of the same TTF - measured across 246 one-line labels the drawn
        # ink reached up to 1.0269x this. Carry the worst case, because a
        # capsule that is a little roomy costs nothing and one that is
        # short prints the last glyph on top of the route.
        w *= KICAD_W_FUDGE
    except Exception:
        w = len(text) * CHAR_W * text_h
    _TEXT_W_CACHE[key] = w
    return w


def label_box(st, text_h, scale=1.0, use_short=False):
    """Rotated-rectangle polygon [(x,y)*4] of a station's label, in board mm.

    Station coords scale with the board; text height and label offset do not.
    The block is vertically centred on the anchor (KiCad's default).
    """
    lines = display_lines(st, use_short)
    w = max(1.0, max(text_width(t, text_h) for t in lines))
    h = (BOX_H + (len(lines) - 1) * LINE_PITCH) * text_h
    ang = math.radians(st.label["angle"])
    d = (math.cos(ang), math.sin(ang))
    n = (math.sin(ang), -math.cos(ang))  # 'above baseline' direction
    px, py = label_anchor(st, scale)
    if st.label["anchor"] == "end":
        px -= d[0] * w
        py -= d[1] * w
    elif st.label["anchor"] == "center":   # KiCad's default justification
        px -= d[0] * w / 2
        py -= d[1] * w / 2
    lo, hi = -h / 2, h / 2
    return [
        (px + n[0] * lo, py + n[1] * lo),
        (px + d[0] * w + n[0] * lo, py + d[1] * w + n[1] * lo),
        (px + d[0] * w + n[0] * hi, py + d[1] * w + n[1] * hi),
        (px + n[0] * hi, py + n[1] * hi),
    ]


def label_offset(angle, anchor, standoff=LABEL_STANDOFF):
    """dx/dy that puts a label's anchor `standoff` mm from the LED centre,
    along the text direction, on the side the anchor implies (start: text
    runs away from the pad; end: text runs toward it)."""
    a = math.radians(angle)
    dx, dy = math.cos(a) * standoff, math.sin(a) * standoff
    if anchor == "end":
        dx, dy = -dx, -dy
    elif anchor == "center":
        dx, dy = 0.0, 0.0
    return round(dx, 2), round(dy, 2)


def leader_segment(st, scale=1.0, pad_r=1.4, gap=0.4):
    """(p1, p2) for a leader hairline from just outside the LED ring to just
    short of the label anchor, or None when the label has no leader."""
    if not st.label.get("leader"):
        return None
    cx, cy = st.x * scale, st.y * scale
    ax, ay = label_anchor(st, scale)
    dx, dy = ax - cx, ay - cy
    ln = math.hypot(dx, dy)
    if ln <= pad_r + gap:
        return None
    ux, uy = dx / ln, dy / ln
    return ((cx + ux * pad_r, cy + uy * pad_r),
            (ax - ux * gap, ay - uy * gap))


def seg_rect(p1, p2, half_w):
    """Convert a line segment to a rectangle polygon of width 2*half_w."""
    dx, dy = p2[0] - p1[0], p2[1] - p1[1]
    ln = math.hypot(dx, dy) or 1.0
    nx, ny = -dy / ln * half_w, dx / ln * half_w
    return [(p1[0] + nx, p1[1] + ny), (p2[0] + nx, p2[1] + ny),
            (p2[0] - nx, p2[1] - ny), (p1[0] - nx, p1[1] - ny)]


def circle_rect(cx, cy, r):
    return [(cx - r, cy - r), (cx + r, cy - r), (cx + r, cy + r),
            (cx - r, cy + r)]


def densify(points, closed, max_seg):
    """Insert extra vertices so no edge is longer than max_seg."""
    out = []
    n = len(points)
    edges = n if closed else n - 1
    for i in range(edges):
        a, b = points[i], points[(i + 1) % n]
        length = math.hypot(b[0] - a[0], b[1] - a[1])
        steps = max(1, int(math.ceil(length / max_seg)))
        for s in range(steps):
            t = s / steps
            out.append((a[0] + (b[0] - a[0]) * t, a[1] + (b[1] - a[1]) * t))
    if not closed:
        out.append(points[-1])
    return out


def repel(points, avoid_pts, keepout):
    """Push each vertex away from any avoid point closer than keepout.

    Used to keep water/land art (copper or silkscreen) clear of LED pads:
    run densify() first so long edges get intermediate vertices too, or a
    near miss in the middle of an edge won't be caught.
    """
    out = []
    for (x, y) in points:
        px = py = 0.0
        for (ax, ay) in avoid_pts:
            dx, dy = x - ax, y - ay
            d = math.hypot(dx, dy)
            if 0 < d < keepout:
                f = (keepout - d) / d
                px += dx * f
                py += dy * f
        out.append((x + px, y + py))
    return out


def simplify(points, tol):
    """Ramer-Douglas-Peucker: drop points that don't bend the line by more
    than `tol`. Runs after densify()+repel() on open polylines (rivers) so
    a long, mostly-straight edge doesn't turn into dozens of tiny render
    segments just because densify had to check it for LED proximity."""
    if len(points) < 3:
        return points
    def seg_dist(p, a, b):
        ax, ay = a; bx, by = b; px, py = p
        dx, dy = bx - ax, by - ay
        if dx == dy == 0:
            return math.hypot(px - ax, py - ay)
        t = max(0, min(1, ((px - ax) * dx + (py - ay) * dy) / (dx * dx + dy * dy)))
        return math.hypot(px - (ax + t * dx), py - (ay + t * dy))
    def rdp(pts):
        a, b = pts[0], pts[-1]
        idx, dmax = -1, tol
        for i in range(1, len(pts) - 1):
            d = seg_dist(pts[i], a, b)
            if d > dmax:
                idx, dmax = i, d
        if idx == -1:
            return [a, b]
        return rdp(pts[:idx + 1])[:-1] + rdp(pts[idx:])
    return rdp(points)


CORNER_R = 5.0  # board outline corner radius (reposition_board.CORNER_R)


def clamp_to_board(points, board_w, margin, board_h=None, corner_r=CORNER_R):
    """Keep vertices at least `margin` inside the board outline - art that
    bleeds off the map edge still needs copper-to-edge clearance. The
    outline has rounded corners, so a vertex in a corner square is also
    pulled inside the corner arc."""
    board_h = board_h if board_h is not None else board_w
    out = []
    rr = corner_r - margin
    for x, y in points:
        x = min(max(x, margin), board_w - margin)
        y = min(max(y, margin), board_h - margin)
        cx = corner_r if x < corner_r else (board_w - corner_r if x > board_w - corner_r else None)
        cy = corner_r if y < corner_r else (board_h - corner_r if y > board_h - corner_r else None)
        if cx is not None and cy is not None:
            dx, dy = x - cx, y - cy
            dd = math.hypot(dx, dy)
            if dd > rr:
                x, y = cx + dx / dd * rr, cy + dy / dd * rr
        out.append((x, y))
    return out


# Copper may run right to the board edge (the water forms no border);
# 0.4 mm is comfortably over the fab's copper-to-edge minimum.
EDGE_MARGIN = 0.4


def prepared_geo(city, scale, avoid_pts, water_keepout=2.0, land_keepout=1.0,
                 edge_margin=EDGE_MARGIN, densify_step=2.0):
    """Every geo shape from the city file, scaled to board mm and adjusted
    to clear LED pads and the board edge. Same output feeds the SVG
    preview, the collision checker, and the PCB art exporter, so what you
    see in the preview is exactly what ends up on copper."""
    board_w, board_h = city.canvas_mm * scale, city.height * scale
    out = []
    for g in city.geo:
        pts = [(x * scale, y * scale) for x, y in g["points"]]
        closed = g["type"] not in ("river", "line")
        if g["type"] == "river":
            keepout = water_keepout + g.get("width", 2.5) * scale / 2
        elif g["type"] in ("water", "lake"):
            keepout = water_keepout
        elif g["type"] == "line":
            # silk furniture goes where authored; a copper hairline (city
            # boundary) must clear the LED pads like the water does
            keepout = water_keepout + 0.2 if g.get("copper") else 0.0
        else:
            keepout = land_keepout
        if keepout > 0:
            pts = densify(pts, closed, densify_step)
            pts = repel(pts, avoid_pts, keepout)
        pts = clamp_to_board(pts, board_w, edge_margin, board_h)
        if not closed and keepout > 0:
            pts = simplify(pts, tol=0.4)
        out.append({**g, "points": pts, "_prepared": True})
    return out


def point_seg_dist(p, a, b):
    ax, ay = a; bx, by = b; px, py = p
    dx, dy = bx - ax, by - ay
    if dx == dy == 0:
        return math.hypot(px - ax, py - ay)
    t = max(0, min(1, ((px - ax) * dx + (py - ay) * dy) / (dx * dx + dy * dy)))
    return math.hypot(px - (ax + t * dx), py - (ay + t * dy))


def poly_point_min_dist(poly, p, closed=True):
    """Distance from p to the nearest edge of poly (its boundary, not just
    its vertices - the closest approach is often mid-edge)."""
    n = len(poly)
    edges = n if closed else n - 1
    return min(point_seg_dist(p, poly[i], poly[(i + 1) % n])
              for i in range(edges))


def hatch_fill(poly, spacing, angle_deg=45, closed=True):
    """Parallel scan-line hatch segments filling `poly` (even-odd rule, so
    concave shapes work too). Returns a list of (p1, p2) segment pairs -
    the single-ink-silkscreen stand-in for a filled color area (parks).
    """
    ang = math.radians(angle_deg)
    ux, uy = math.cos(ang), math.sin(ang)   # hatch line direction
    nx, ny = -uy, ux                        # scan axis (perpendicular)
    proj = [x * nx + y * ny for x, y in poly]
    lo, hi = min(proj), max(proj)
    n = len(poly)
    edges = n if closed else n - 1
    segs = []
    k = math.floor(lo / spacing)
    d = k * spacing
    while d <= hi:
        hits = []
        for i in range(edges):
            (x1, y1), (x2, y2) = poly[i], poly[(i + 1) % n]
            p1n, p2n = x1 * nx + y1 * ny, x2 * nx + y2 * ny
            if p1n == p2n:
                continue
            if min(p1n, p2n) <= d <= max(p1n, p2n):
                t = (d - p1n) / (p2n - p1n)
                hx, hy = x1 + t * (x2 - x1), y1 + t * (y2 - y1)
                hits.append((hx * ux + hy * uy, hx, hy))
        hits.sort()
        for i in range(0, len(hits) - 1, 2):
            a, b = hits[i], hits[i + 1]
            if b[0] - a[0] > 1e-6:  # drop degenerate corner-grazing hits
                segs.append(((a[1], a[2]), (b[1], b[2])))
        d += spacing
    return segs


def point_in_polygon(p, poly):
    """Ray-casting point-in-polygon test. Correct for concave polygons,
    unlike polys_intersect() (SAT), which requires convex shapes - use
    this for anything tested against a coastline/river outline."""
    x, y = p
    inside = False
    n = len(poly)
    x1, y1 = poly[-1]
    for x2, y2 in poly:
        if (y1 > y) != (y2 > y):
            xin = x1 + (y - y1) * (x2 - x1) / (y2 - y1)
            if x < xin:
                inside = not inside
        x1, y1 = x2, y2
    return inside


def segs_intersect(p1, p2, p3, p4):
    def orient(a, b, c):
        v = (b[0] - a[0]) * (c[1] - a[1]) - (b[1] - a[1]) * (c[0] - a[0])
        return 0 if abs(v) < 1e-9 else (1 if v > 0 else -1)
    o1, o2 = orient(p1, p2, p3), orient(p1, p2, p4)
    o3, o4 = orient(p3, p4, p1), orient(p3, p4, p2)
    return o1 != o2 and o3 != o4


def seg_box_overlap(seg, box):
    """True if segment (p1, p2) touches the convex 4-point box."""
    (p1, p2) = seg
    if point_in_polygon(p1, box) or point_in_polygon(p2, box):
        return True
    return any(segs_intersect(p1, p2, box[i], box[(i + 1) % 4]) for i in range(4))


def box_poly_overlap(box, poly, closed=True):
    """True if the (small, convex) box overlaps the (possibly large,
    concave) poly - any box corner inside poly, any poly vertex inside
    box, or any edge of one crossing an edge of the other."""
    if any(point_in_polygon(c, poly) for c in box):
        return True
    if any(point_in_polygon(v, box) for v in poly):
        return True
    n = len(poly)
    edges = n if closed else n - 1
    for i in range(4):
        a, b = box[i], box[(i + 1) % 4]
        for j in range(edges):
            c, d = poly[j], poly[(j + 1) % n]
            if segs_intersect(a, b, c, d):
                return True
    return False


def _project(poly, axis):
    dots = [p[0] * axis[0] + p[1] * axis[1] for p in poly]
    return min(dots), max(dots)


def polys_intersect(a, b):
    """Separating-axis test for two convex polygons."""
    for poly in (a, b):
        for i in range(len(poly)):
            x1, y1 = poly[i]
            x2, y2 = poly[(i + 1) % len(poly)]
            axis = (y1 - y2, x2 - x1)
            amin, amax = _project(a, axis)
            bmin, bmax = _project(b, axis)
            if amax < bmin or bmax < amin:
                return False
    return True
