funvill/tokyo-metro-pcb/(commit log)

2026-10-20 Tokyo Metro PCB: the organic map and its pipeline
    A 320 x 280 mm board carrying 248 WS2812B LEDs, one per station, across
    Tokyo Metro's nine lines, Toei's four, the JR Yamanote loop, the Toden
    Arakawa tram, the Yurikamome, the Rinkai line and the Shinkansen.
    The map is organic rather than schematic. Stations stand where the city
    puts them - 6 m mean error - and the track follows the real rails from
    OpenStreetMap, bridges and tunnels included: the Rainbow Bridge with its
    Shibaura spiral, the 1,236 m Arakawa-Nakagawa truss, the Tokyo Port
    Tunnel. 322 of 333 legs carry a real alignment.
    Station names sit in capsules that knock the route silkscreen out behind
    them, so a name may lie across a l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
2026-10-20 Rebuild the KiCad board from the organic map
    Placement, outline and artwork all come from the new input/tokyo.json:
    248 LEDs at their stations, 13 row capacitors, the controller group at
    (40, 220), and 1,555 route segments.
    The route silkscreen is now cut around the label capsules and the LED
    pads. tools/capsules.py holds that geometry and both preview_map and
    export_art import it, rather than each keeping its own copy - every time
    those two have had separate definitions they have drifted, and the
    optimiser ends up solving a board nobody is drawing.
    DRC: 2 shorts (mounting holes in the bay), 28 isolated copper islands and
    16 starved thermals, all of which are the known front-pour-in-pieces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
2026-10-20 Set the label face on the board text, and draw the capsule borders
    The board was drawing its names in KiCad's default stroke font while
    every label placement, capsule and collision check had been computed from
    Archivo Narrow SemiBold - 35 to 59% narrower - so the names were wider
    than the space cleared for them. The face is now set on all 250 gr_text
    blocks.
    The capsule outlines are drawn too: 248 unfilled gr_poly on F.SilkS at a
    0.12 mm stroke. They were being computed as keepouts for the route
    silkscreen and never emitted, so the board had the cleared space with no
    border round it.
    tools/capsules.py is the single definition both preview_map and
    export_art use for that geometry.
    NOT YET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
2026-10-20 Embed Archivo Narrow in the board so the labels render as designed
    KiCad was substituting Verdana Bold for the missing face, which is wider
    than the stroke font it replaced - so setting the face alone had made the
    labels worse, not better. With the font installed, KiCad resolves it and
    board.EmbedFonts() writes the TTF into the file's embedded_files section.
    The board now carries its own font and does not depend on what any
    machine has installed; that is most of the 7 MB.
    EmbedFonts() needs two things and reports neither when they are missing:
    the board-level embedded_fonts flag has to be yes (it was no, and there
    are 282 other occurrences at footprint level that must be left alone),
    and th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
2026-10-20 Cut routes against the capsule grown by half the stroke
    The routes were still crossing the capsules because the cut was made
    against the centre line, not the drawn stroke. A route is 0.75 mm wide
    (1.65 mm for the Shinkansen), so a centre line can clear a capsule by a
    comfortable margin while the stroke still paints over it by up to half
    its width - which is exactly what was happening at Kayabacho and
    Kyobashi.
    The keepout is now grown by half the stroke before the centre line is
    differenced against it, cached per distinct width so the union is only
    buffered twice rather than once per segment.
    This keeps the artwork vector. Rendering the silkscreen to an image and
    importing that would also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
2026-10-20 Draw the routes as solid shapes with the elements cut out of them
    The lines stopped short of every LED and capsule, ringing each one with
    about half a millimetre of dark. The cause: the cut was made on the
    route's CENTRE LINE, and KiCad draws a segment end flush, so trimming the
    centre line to clear an element left the stroke ending half a width early
    - then the pad clearance added more on top.
    The strokes are now unioned into one shape and the keepouts subtracted
    from it, which is a solid line with a hole in it. That is what the map
    wants, and it also removes the seams between consecutive segments, so a
    line reads as one stroke instead of a chain of them. 807 merged polygons
    replace roughl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
2026-10-20 Cut the capsules out of the water's mask opening
    A capsule over the bay showed gold inside it. The water reads as bare
    copper because its F.Mask polygon is an OPENING that exposes the copper,
    and the capsule was not taken out of that opening - so the label sat in a
    gold lozenge instead of on the same green as everywhere else.
    The capsules are now subtracted from the F.Mask polygon. The F.Cu
    polygon is left alone: the copper stays, covered by mask, because there
    is nothing to gain by removing copper nobody can see.
    The capsule setup moved above the water call, since the mask opening now
    depends on it.
    mask_under_silk now reports 12 of 14 water openings cut back, against 7
    of 9 before - the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
2026-10-20 README: show the KiCad board, not the preview
    test-results/board.png is now the kicad-cli render of the actual board
    artwork - trimmed to the outline and scaled to 2400 px - rather than the
    preview_map render it was showing. The two look similar by design, which
    is exactly why the caption says which one it is.
    The status line said the KiCad board still had the old schematic-style
    artwork and needed rebuilding. It does not; it is built from this map.
    "Still to do" rewritten to match: routing is the next step, not building
    the board. The DRC that is left is listed with it, including which of it
    is expected - the 11 silkscreen-at-board-edge warnings are the line stubs
    running off the edge on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
2026-10-21 Reconnect R1, and make the checks assert what they only printed
    make_schematic.py deleted the LED_DATA and LED_IN global labels off R1's
    two pins and never inserted the replacement wire+label blocks it had
    built: it appended `gen` and dropped `tidy`. GPIO1 dead-ended at its test
    point, both of R1's pads fell to unconnected-(R1-Pad*), and LED1's DI sat
    alone on a one-node net. The chain itself was continuous end to end,
    which is all check_led_chain.py asserted, so every check passed on a
    board where not one LED would have lit.
    The replacement blocks were wrong as well, and nobody could see it
    because they were never rendered. For a vertical schematic label the
    angle does not choose which sid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
2026-10-21 Fit the capsule to the text KiCad draws, and keep it off the LED
    Three separate ways the artwork disagreed with itself.
    The seam. gr_poly carries one ring, so each hole is bridged into the
    outer ring by a zero-width seam - and both copies of ring_with_holes
    joined to hole[0], whichever vertex shapely happened to start the ring
    at, making the seam an arbitrary chord. At Tsukishima it ran 3.9 mm from
    the far shore straight through the middle of the LED's own keepout hole
    and across LED20's pads. Every check here said 2.995 mm clear, because
    buffer(0) collapses a doubled edge before anything measures it; KiCad's
    DRC reads it as boundary and called it two shorts and a clearance
    violation. Bridg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
2026-10-21 Every LED pin 1 up, and a polarity mark that can be read
    Pads 1 and 4 of the XL-1615 sit on the SAME edge of the part, so a part
    fitted 180 degrees out swaps GND with DI and +5V with DO. The vendor's
    silk dot was on pad 1's side but centred between the two pads: it marked
    the side and nothing more. It now sits on pad 1's row, 0.750 mm from
    pad 1 and 1.172 from pad 4 on all 248, in the project library as well as
    on the board so the two agree. F.Fab was already unambiguous.
    The LEDs were each turned so DOUT faced the next station - eight angles
    across the board, which is right if the router is what you optimise and
    wrong for whoever fits 248 parts. All 248 are at 270 degrees now, pin 1
    up, wi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
2026-10-22 Route to two different planes, and move the back side to the edge
    The front pour is +5V now and the back is GND, so autoroute.py can no
    longer force every pour onto B.Cu. That was right while both planes were
    GND and the artwork cut the front one into islands - the router then
    dropped a via to the back pour for every ground pad - but with two nets
    it would hand the router two different nets poured on the same layer.
    Each pour goes out on its own layer, and the plane assignment is printed
    so a wrong one is visible rather than silent.
    reposition_board.py was never placing TP1-4, LED_OUT1 or +5V1, so they
    sat where the Montreal board left them: four test points in the middle
    of the map, LED_OU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
2026-10-22 Autoroute the chain, and take out the copper that connects nothing
    Planes on both layers: +5V on the front, GND on the back, with the
    back-side hardware in a row along the bottom edge and the XIAO 40 mm up
    from it so the cable has somewhere to go. The Power net class widens to
    0.8 mm.
    Freerouting took the data chain from 863 unrouted down to 34. Importing
    the result left a lot of copper behind that was not carrying anything:
    - 116 vias with nothing on the far end
    - 67 track stubs, which only appeared as the vias came out - the
    pattern was pad -> short track -> via -> nothing, so removing a via
    turned its track into the dangling item and exposed the one behind
    it. Four round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
